metcalf/shop-exhaust-control/docs/site/dust collector.jpg

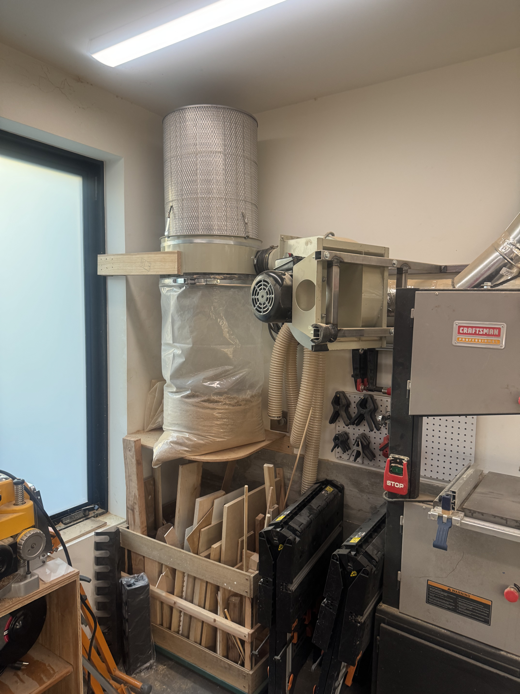
docs/site/dust collector.jpg
