metcalf/shop-exhaust-control/docs/site/mounting location option - near rear door.jpg

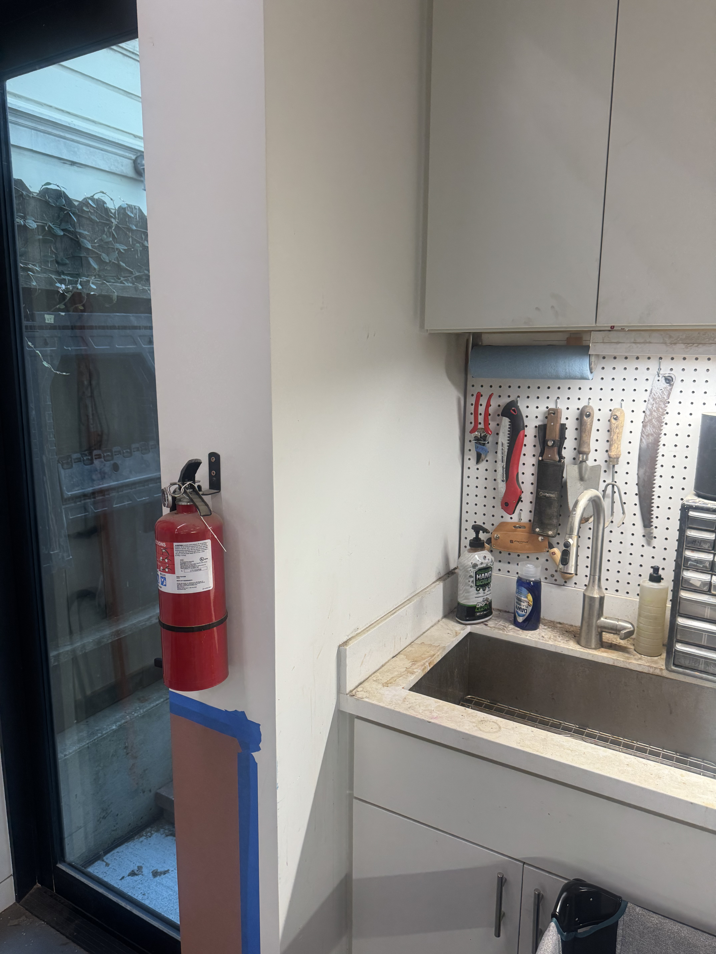
docs/site/mounting location option - near rear door.jpg
