metcalf/shop-exhaust-control/docs/decisions.md

# Decision Log

ADR-lite format. Status is one of: **Proposed**, **Accepted**, **Superseded by D-nnn**, or **Rejected**. Gate approvals are logged here too.

Keep this log to live decisions. When one is superseded, delete it if the new entry's alternatives already record why; keep a rejected entry only if the idea is likely to be re-proposed. Working assumptions live in `docs/context.md` until they're decided. IDs are never reused.

Template:
```
## D-nnn: Title
- Date:
- Status:
- Context:
- Decision:
- Alternatives considered:
- Consequences:
```

---

## D-001: Exhaust fan controller is the pilot project
- Date: 2026-10-22
- Status: Accepted (Andrew)
- Context: Two related projects, exhaust fan control and DC control, plus a new Claude-led design process to try out.
- Decision: Build the exhaust controller first.
- Alternatives considered: DC first (higher value, but more I/O, distributed wiring and a 3 HP motor contactor).
- Consequences: The exhaust project defines the `DC_RUNNING` interface. The DC project reuses this repo's structure and its process notes.

## D-002: Separate controllers, coupled by one signal
- Date: 2026-10-22
- Status: Accepted (Andrew)
- Context: The two systems share only "DC running," plus an optional shared UI.
- Decision: Independent ESP32 nodes. Shared UI and history go in Home Assistant.
- Alternatives considered: One combined controller.
- Consequences: Each node must work on its own (NFR-01). The interface lives in `docs/interfaces.md` §1; transport is BLE (D-016).

## D-003: Local physical controls; Home Assistant for history and alerts
- Date: 2026-10-22 (revised 2026-10-23)
- Status: Accepted (Andrew)
- Context: Andrew doesn't want to pull out a phone at the bench.
- Decision: Physical controls and indicators in the shop. Need not be analog: a small display is fine, resistive touch possible but physical controls preferred. Not presumed to be a fixed mode list; the interaction model is in `docs/requirements.md` §2. Home Assistant handles logging, notifications and remote viewing, and may trigger the same actions as the panel.
- Consequences: Precedence between panel and Home Assistant is decided at G2 (`docs/interfaces.md` §4). *Update 2026-10-24:* HA control dropped for v1 (FR-16); HA is read-only, so no precedence rule is needed yet.

## D-007: Bare ESP-IDF firmware, reusing the hvac_control network stack
- Date: 2026-10-23
- Status: Accepted (Andrew, 2026-10-23, including extraction)
- Context: Andrew writes ESP32 firmware in bare ESP-IDF. `~/code/hvac_control` already has a working Wi-Fi/OTA/remote-log/MQTT base (`components/wifi`) and two Home Assistant MQTT-discovery clients built on it. The DC controller will need the same stack.
- Decision: ESP-IDF in C++, not ESPHome. Control logic is a pure C++ component, host-tested. Reuse `components/wifi`, extracted with history into `metcalf/esp-iot-core` and consumed as a git submodule at `components/esp-iot-core`, matching how hvac_control already pulls in its other shared libs. HA integration follows the `MqttHomeClient`/`MqttZCHomeClient` pattern.
- Alternatives considered:
  - ESPHome: less code for HA entities, but not Andrew's workflow, and complex logic ends up in C++ external components anyway.
  - Copy `components/wifi` into this repo: fastest, but forks it three ways once the DC project starts.
- Consequences: hvac_control switches to the submodule on branch `extract-esp-iot-core`, mounted at `components/esp-iot-core` (consumers `REQUIRES esp-iot-core`); both firmware builds and host tests pass. `release.sh` takes `OTA_DIR_PREFIX` (default `hvac_control_`); each project sets its own OTA URL template, MQTT user and `remote_spec.cfg` in gitignored per-checkout files. The Python reference model is dropped (Andrew, 2026-10-23); the logic has one implementation, tested on the host in C++.

## D-008: Custom PCB with third-party assembly
- Date: 2026-10-23
- Status: Accepted (Andrew, direction; mains and DIN-rail constraints lifted 2026-10-23); details confirmed at G2/G3
- Context: Andrew wants to try a custom PCB for this project. He has designed mains PCBs before. He can hotplate-reflow SMD and is open to third-party PCBA.
- Decision: v1 uses a custom PCB: ESP32-S3 module, power, PM sensor connector, optocoupled `DC_RUNNING` input, control-panel and indicator I/O, and outputs. Mains on the board is allowed; whether the supply, relay or contactor are on or off board is decided at G2. Mains sections follow IEC 62368-1 creepage/clearance with reinforced insulation to accessible low voltage, documented in `pcb/SAFETY.md` (SR-01a). Enclosure is custom; no DIN-rail constraint. KiCad design, assembled by JLCPCB by default using parts it stocks; leftovers hand-soldered or reflowed by Andrew.
- Alternatives considered:
  - Dev board plus modules: no layout risk, but more wiring and a bigger enclosure. Kept as the fallback on the same pinout.
  - Low-voltage-only board (initial draft): simpler review, but rules out an on-board supply or relay that may make the build smaller. Remains an option at G2.
- Consequences: Phase 3 adds a KiCad project with ERC/DRC and fab/PCBA outputs; G3 review covers the board. The PCB order is a purchase, approved at G4. Claude's layout needs Andrew's review in KiCad. Mains layout is the highest-risk part of Claude's weakest area, so Andrew reviews it at G3 against `pcb/SAFETY.md`.

## D-009: Occupancy-based Auto; encoder plus configurable buttons
- Date: 2026-10-24
- Status: Accepted (Andrew, direction); floor level and thresholds set at commissioning
- Amended 2026-11-09 by D-048: the encoder and buttons are replaced by a touch panel. The Auto, hold and scene model stands.
- Context: Requirements review. Spraying is infrequent and doesn't justify a dedicated button. Andrew expects the sensors to do most of the work, with manual overrides rare.
- Decision: In Auto, an occupied shop always gets a low ventilation floor; the fan turns off only when the shop is vacant and the air is clear. Panel: encoder with push (multi-step hold entry, defaulting to the last values) plus about 4 unlit buttons whose assignments are configuration (initially Auto, Quiet, Boost, spare). Scenes stay as an extensible concept; Spray is a scene, not a button. No backlit buttons; state is shown on the display and the ambient indicator.
- Alternatives considered:
  - Sensor-only on/off (previous FR-02): no baseline ventilation while working.
  - Dedicated Spray button, or one press per action with no menus: optimizes for rare actions.
- Consequences: The occupancy input moves from S to M (FR-07); it's trusted as correct, with no failure handling (Q-17), and the display shows occupancy. PCB routes about 4 button inputs with no LED drivers. Button mapping lives in config, not in the state machine.

## D-010: PCB/electrical toolchain built around Claude's weak spots
- Date: 2026-10-24
- Status: Accepted (Andrew, 2026-11-09). KiCad 10 in place of 9 (D-035); no mains on the board (D-018), so the mains-zone items don't apply
- Context: Claude is reasonable at schematic topology but error-prone at symbol/footprint pin mapping and readable sheet placement, and weak at layout (D-008). The toolchain should turn those into scripted, checkable steps.
- Decision:
  - **Schematic:** native KiCad 9, generated with `kiutils` (Python) rather than hand-written S-expressions. Symbols, footprints and 3D models from `easyeda2kicad` by LCSC part number; LCSC fields via `kicad-jlcpcb-tools`.
  - **Verification:** render sheets and board with `kicad-cli` (`sch export svg`, `pcb export svg`, `pcb render`) and review the images; scripted netlist assertions against datasheet pin requirements (strapping pins, EN RC, decoupling, opto input); ngspice for the analog bits (`DC_RUNNING` input, snubbers, supply). Results are committed.
  - **Mains spacing:** KiCad 9 custom DRC rules, including `creepage`, encode the IEC 62368-1 spacings; `pcb/SAFETY.md` cites the rule file. Third-party layout tools never stand in for this check.
  - **Layout:** Claude scripts placement (pcbnew/IPC API): board outline, edge connectors, antenna keepout, mains zone with slots, net classes. Mains section is pre-routed and locked. From the same locked placement, generate one candidate with Freerouting and one with Quilter (free tier, KiCad in/out); both must pass our DRC; Andrew picks one and touches it up.
  - **Outputs:** KiBot/KiKit for Gerber/BOM/CPL; InteractiveHtmlBom for hand-placed parts.
  - **Off-board wiring:** WireViz (YAML) in `electrical/`.
  - **Mechanical fit:** `kicad-cli pcb export step` into the build123d enclosure assembly (D-011) for interference checks.
- Alternatives considered:
  - Hand-written `.kicad_sch`: works but unreadable placement, no structure for checks.
  - SKiDL/atopile (circuit-as-code): good netlists, but no schematic sheet for Andrew to review. Reconsider for the DC controller.
  - Flux: browser platform with its own format; conflicts with the repo/KiCad/`kicad-cli` workflow.
  - DeepPCB: overlaps Quilter; try only if Quilter disappoints. JITX: commercial, overkill.
- Consequences: Phase 3 needs KiCad 9 (`kicad-cli`, creepage DRC) on the working machine (Q-14), plus Python deps (`kiutils`, `easyeda2kicad`) and Freerouting (Java). Quilter is a cloud upload and its creepage/slot handling is unverified, hence our DRC as the gate. The Freerouting-vs-Quilter comparison is recorded in `docs/process-notes.md` for the DC project.

## D-011: Mechanical toolchain: build123d, checked by renders and geometry tests; outsourced PA12 enclosure
- Date: 2026-10-24
- Status: Proposed — needs Andrew (build123d choice accepted in principle by Andrew 2026-10-24; enclosure material tied to Q-18)
- Context: Claude's mechanical errors are mostly orientation/selector mistakes, assembly fit, and manufacturability, not the parametric geometry itself. Andrew expects to outsource SLS printing of the enclosure.
- Decision:
  - **CAD:** build123d (FOSS, OCCT kernel, STEP export) instead of CadQuery. Explicit objects, `Location`s and named faces replace chained string selectors (`>Z`), the main source of silent orientation errors. No mechanical code existed yet, so switching is free.
  - **Single source of truth:** connector, mounting-hole, display and encoder positions are read from the `.kicad_pcb` file via pcbnew Python, never retyped. The KiCad STEP export goes into the assembly.
  - **Checks:** headless renders (iso, six orthographic views, section cuts) via PyVista/trimesh for Claude to review; pytest assertions for bounding boxes, minimum wall thickness, boss/insert clearances, and zero pairwise interference volume across the assembly (PCB included); trimesh watertight/manifold checks on exported meshes.
  - **Fabrication outputs:** STEP for Fusion; dimensioned drawings via FreeCAD headless (TechDraw) for anything Andrew cuts or welds (mounts, brackets); 1:1 PDF templates for cutouts and hole patterns, checked on the real parts before cutting.
  - **Enclosure process:** outsourced PA12 powder-bed nylon. Default MJF PA12 at JLC3DP, ordered with the PCB; SLS if the vendor or finish demands it. Design rules: ≥2 mm walls, brass heat-set inserts in bosses, ~0.3 mm clearance on mating fits, powder-escape holes for closed voids, gasketed lid if needed for dust.
- Alternatives considered:
  - CadQuery: same kernel and fine, but its selector API produces wrong-face errors that build without complaint.
  - Zoo (KCL/text-to-CAD): commercial; duplicates code-CAD with more lock-in.
  - SLA resin: brittle for a shop enclosure. FDM: fine if Andrew prints, but slower to dial in remotely. Off-the-shelf listed enclosure with machined cutouts plus a printed bezel: the fallback if mains ends up inside (Q-18).
- Consequences: Phase 3 mech needs Python deps (`build123d`, `pyvista` or `trimesh`, `pytest`) and FreeCAD for drawings. Standard PA12 is not flame-rated (typically UL94 HB), so it can't be the fire enclosure around mains; Q-18 resolves this at G2. CLAUDE.md updated from CadQuery to build123d.

## D-012: One Sensirion SEN65 module for PM, VOC/NOx and RH/T
- Date: 2026-10-24, revised 2026-10-25
- Status: Accepted (Andrew, 2026-10-25, Q-24)
- Context: Sensors went through PMS5003 → SPS30 + SGP41 (Q-08, Q-09) → plus a coarse sensor and an SHT4x for VOC humidity compensation. The SHT4x needs enclosure self-heating compensation; the SEN55 combines everything but is NRND at Sensirion (`sourcing/pm-sensor.md`).
- Decision: A single SEN65 (SEN6x family, active): PM mass and number concentrations, VOC and NOx indices, RH/T. No coarse dust sensor (FR-17 dropped) and no separate RH/T sensor, so the sensor bay has one airflow path.
- Alternatives considered:
  - SEN55: cheaper and has a gas-only mode, but NRND.
  - SPS30 + SGP41 (+ SHT4x): independent failure of PM and VOC, but two airflow paths and the compensation problem.
  - Adding a coarse sensor: dropped for one airflow path; v2 candidate.
- Consequences:
  - No gas-only mode: VOC is measured only while the module measures PM. Acceptable (Andrew): when dust is high and PM sampling is sparse, the fan is already high.
  - The VOC baseline must survive module sleep (FR-14); check the SEN6x for algorithm-state backup/restore at G2, else keep a host-side baseline on the raw signal.
  - SEN6x runs on 3.3 V with peaks of ~350 mA for 2 ms; the supply and decoupling are sized at G2.
  - Fan auto-clean behavior isn't documented for SEN6x; plan a manual clean command on a schedule (NFR-02).
  - A module fault takes out PM and VOC together (SR-04).
  - Price unchecked; the SEN66 is ~$62 at DigiKey and the SEN65 should be lower. Checked at G4.

## D-013: Fan and node on always-on 120 V; lighting relay no longer switches the fan
- Date: 2026-10-25
- Status: Accepted (Andrew, 2026-10-25, Q-19: use the existing unswitched receptacle)
- Context: Survey §2: the fan's receptacle is switched by a relay driven from the 24 VAC lighting transformer, so the fan loses power when the lights go off. Auto (D-009) turns the fan off only when the shop is vacant *and* the air is clear, which needs the fan to run after the lights go off.
- Decision: Plug the fan and the node's listed supply into the existing unswitched receptacle in the cabinet. No rewiring. The 24 VAC transformer stays and becomes the occupancy input only (FR-07).
- Alternatives considered:
  - Keep the relay: the fan stops when the lights go off, so no vacant clear-down and Spray run-on dies with the lights. Contradicts FR-02/FR-08.
  - Controller switches mains itself: unnecessary, since 0 % PWM is true off (Q-15), and it would put mains in the enclosure (Q-18).
- Consequences: IR-05. No mains work, so G3 for this is a check that the receptacle's circuit is suitable. The fan's off state now depends entirely on the control port. The fan runs at full speed with the cable unplugged (Q-15), but SR-08 holds it off whenever the node is unpowered or booting, so a dead node means no exhaust until noticed (HA offline alert, FR-13).

## D-015: Controller at the north (exhaust) end
- Date: 2026-10-25
- Status: Accepted (Andrew, 2026-10-25), replaces D-014 (panel above the miter station). Spot: under the north-wall upper cabinets, < 10 ft of cable to the fan cabinet (Q-23). **Spot amended by D-033** (refrigerator side panel); the north-end choice stands
- Context: Makeup air enters at the south end and the hood exhausts at the north, so air flows the length of the shop. A sensor at the miter station (D-014) would be blind to everything downstream of it: the lathe, the north bench (soldering) and spraying north of it.
- Decision: Panel, ambient indicator and sensors go together at the north end, out of the hood's capture zone. Spot: hung under the north-wall upper cabinets (Q-23), at least 3 ft from the hood's edge, facing south down the shop. The enclosure hangs from the cabinet bottom with the display and controls angled toward the user, and the sensor inlet faces into the room. All site wiring (fan port, 24 VAC, supply) is local to the fan cabinet. Whether the DC gets its own panel or shares this one is deferred to the DC project.
- Alternatives considered:
  - Above the miter station (D-014, accepted earlier on Q-10): close to the work and the DC wiring, but blind downstream and needed a 35 ft ceiling cable. Splitting the sensors from the panel was also possible, but separating them buys nothing once the sensors are at the north end.
  - Directly beside the fan, under the cabinet (survey option 3): least wiring, but inside the hood's draw and poorly visible.
- Consequences: Sensing integrates the whole shop and clears last, so the off decision is conservative; upstream sources are detected later, which DC boost largely covers. Manual controls are at the north end, by the interior door you enter through. The DC wired link is no longer nearly free, which led to D-016. IR-04 shrinks to a short local cable.

## D-016: BLE advertising for the DC link, with no wired or MQTT path
- Date: 2026-10-25
- Status: Accepted (Andrew, 2026-10-25). **Amended by D-025** (wired backup input added)
- Context: With the controller at the north end (D-015), a wire from the DC would be a separate ~30 ft run. ESP-NOW was considered, but it shares the Wi-Fi channel, so AP outages and channel changes would need a channel-sweep scheme and an `esp-iot-core` change.
- Decision: The DC node broadcasts `DC_RUNNING` in BLE advertisements; the exhaust node scans and treats P-24 of silence as "not running". No wired input, and no MQTT fallback, for simplicity (Andrew). Message format in `docs/interfaces.md` §1, versioned and with room for DC status and a reverse direction.
- Alternatives considered:
  - Dry contact into an optocoupler: robust and simple, but a dedicated wire run.
  - ESP-NOW: better range and lower latency, but tied to the Wi-Fi channel.
  - MQTT node-to-node fallback: dropped; it adds a second path to test for a non-critical function.
  - BLE GATT connection: more state than a few bytes at a low rate needs.
- Consequences: BLE and Wi-Fi time-share the radio; the scan duty and coexistence get tested with OTA (AC-22). Adds the NimBLE stack to RAM and flash; checked at G2, with a PSRAM module as the fallback. Supersedes the transport text in D-002's consequences; D-002 itself (separate nodes, coupled by one signal) still stands. Loss of the link costs only boost. Commands to the DC, if ever added, need authentication.

## D-017: VOC index computed on the node from the SEN65 raw signal
- Date: 2026-10-25
- Status: Proposed (G2). Reversible in firmware
- Context: FR-14 needs the VOC baseline to survive module Idle. The module's index algorithm resets whenever a measurement starts. D-012 left two options: the module's algorithm-state backup/restore, or a host-side baseline on the raw signal.
- Decision: Run Sensirion's open-source gas index algorithm (BSD-3, plain C) on the node, fed one step per valid 1 s raw VOC reading. Pause it (keep its state) while the module isn't measuring and for C-07 after each start. Save the state to NVS hourly and restore it at boot. Publish the module's own index too, as a check.
- Alternatives considered: Module state backup/restore (fewer lines of code, but behaviour across long Idle is undocumented, and recorded traces can't be replayed through the module). It stays as the fallback if the raw signal proves unusable on the bench.
- Consequences: Deterministic, so host tests and HA replay run exactly the same algorithm (FR-12, AC-28). Phase 3 confirms that the SEN6x raw VOC command exists and is humidity-compensated inside the module. Restoring a stale state after a long node outage is accepted; the algorithm re-adapts over hours.

## D-018: No mains in the design; listed 12 V adapter
- Date: 2026-10-25
- Status: Proposed (G2). **Adapter and on-board supply amended by D-030** (5 V USB-C); "no mains" stands
- Context: CLAUDE.md leaves on- or off-board mains to architecture. The fan is switched off through its control port (Q-15, D-013), so there's no relay or contactor to host. Q-18 (a) prefers no mains in the printed enclosure.
- Decision: No mains on the PCB or in the enclosure. A UL-listed 12 V / ≥ 1 A Class 2 adapter plugs into the always-on cabinet receptacle and feeds a barrel jack. On board: fuse, reverse-polarity FET, TVS, 12→5 V buck, 5→3.3 V buck, plus a switched 5→3.3 V LDO for the SEN65.
- Alternatives considered: 5 V USB-C adapter (cheaper by one buck, but ~0.3 V drop over 10 ft at peak, and a second external USB-C next to the fan's USB-C port invites mis-plugging; see D-020). On-board mains supply (saves the adapter, but brings SR-01a, `pcb/SAFETY.md` and a flame-rated enclosure for no functional gain).
- Consequences: SR-01a isn't triggered. G3 covers only the receptacle circuit, the adapter listing and the 24 VAC hookup (SR-07). PA12 is fine as the enclosure material.

## D-019: One enclosure: sealed electronics above an open sensor bay
- Date: 2026-10-25
- Status: Superseded by D-057 (2026-11-10). Was accepted with G2 (Andrew, 2026-10-28). Mounting amended by D-033: wall cleat on the fridge side panel, not a cabinet bracket
- Context: NFR-03/04/09, D-015 (under the north cabinets), Sensirion's guidance to keep the module below heat sources.
- Decision: One PA12 enclosure hung from a cabinet bracket. The sealed electronics compartment is on top, with the panel on the front face and the light bar along its bottom edge. The open sensor bay is below, with a front grille and a tool-less cover; the module cable crosses through a sealed grommet. Cables enter at the back or top with strain reliefs.
- Alternatives considered: A separate sensor pod on a short cable (better thermal separation, but I²C over a longer run and two enclosures). Sensor bay beside the electronics (shorter enclosure, but at the same height as the heat).
- Consequences: Phase 3 mech models two compartments and a grommet pass-through. The SEN65 RH/T offset is tuned at commissioning.

## D-020: Flashing USB is internal; the fan port is the only external USB-C
- Date: 2026-10-25
- Status: **Superseded by D-030** (USB-C is now external, as the power input and flash/log port). Earlier amended by D-026
- Context: The S6 control cable is USB-C (stock controller J1). If the fan cable went into a node USB port, the fan's +10 V and GND would land on non-isolated node pins, bypassing SR-09.
- Decision: The ESP32-S3 native USB-C is inside the electronics compartment, reachable only with the lid off. OTA is the normal update path (NFR-11). Power comes in on a barrel jack (D-018).
- Alternatives considered: External flashing port with a label (relies on the label). A non-USB connector for the fan (needs a custom or cut fan cable).
- Consequences: First flash and recovery need the lid off. The fan-port receptacle is labelled "FAN".

## D-021: BLE DC link: payload v1.0, fast-burst advertising, 30 % scan
- Date: 2026-10-25
- Status: Proposed (G2). Shared with the DC project, so changes after G2 need a decision entry
- Context: D-016 chose BLE advertising. AC-22 needs assertion within 3 s and no false assertions, with Wi-Fi running.
- Decision: Manufacturer-specific data with company ID 0xFFFF, magic "MS", version, type, sender, sequence, flags (bit 0 `DC_RUNNING`) and reserved status and MAC fields (`docs/interfaces.md` §1.1). The DC side advertises every 100 ms for 5 s after a change, then every 500 ms. The exhaust side scans passively, 30 ms every 100 ms.
- Alternatives considered: A constant 500 ms interval with a higher scan duty (more radio time taken from Wi-Fi). Extended advertising (BLE 5; not needed for 21 bytes).
- Consequences: The DC project implements the encoder from this table. The exhaust side tests the parser and timeout on the host.

## D-022: ESP32-S3-WROOM-1-N16R8, 2.8" IPS display module, LVGL
- Date: 2026-10-25
- Status: Proposed (G2)
- Amended 2026-11-09 by D-048: the display is the capacitive-touch DLS29028B; "no touch" and the ST7789 option no longer apply.
- Context: D-008 named the ESP32-S3. D-016 flagged NimBLE RAM, with a PSRAM module as the fallback. Andrew's hvac_control already uses LVGL.
- Decision: The N16R8 module (octal PSRAM, so GPIO 35–37 are unavailable). A 2.8" 240×320 **IPS** SPI display module (ST7789 or ILI9341-IPS class) on a header, **no touch** (Andrew, 2026-10-28; was 2.0"). LVGL via `esp_lcd`.
- Alternatives considered: N8 without PSRAM (cheaper by ~$1; RAM is tight with NimBLE, TLS OTA and LVGL). A bare FPC panel (cheaper, but a fine-pitch connector and backlight circuit on our board). 2.0" IPS (smaller enclosure; same 240×320, so text is ~30 % smaller at the user's distance under the cabinet). 2.8" TN (common and cheap, but washes out viewed from below). Resistive touch (dulls the image; the encoder and buttons cover input, D-009).
- Consequences: GPIO plan in `docs/interfaces.md` §2. The display module's outline feeds the enclosure in phase 3; the bezel and board grow to about 50 × 86 mm for the module. Backlight ~2× the 2.0" draw (power budget updated, ≈ 1.5 W typical). Sourcing must confirm IPS from the panel datasheet. Cost ≈ +$3 per board.

## D-023: Fan-powered, fail-off isolated fan interface
- Date: 2026-10-25
- Status: Accepted with G2 (Andrew, 2026-10-28). Q-26 answered: the stock controller draws ≈ 9.3 mA from the port, so the ≤ 9 mA budget is within demonstrated capacity. 5 V LDO removed by D-044
- Context: SR-08 requires the fan to be off with the node unpowered, with the hold-off powered from the fan side. SR-09 requires isolation. FR-18 needs the tach.
- Decision: A fan-side N-MOSFET holds the speed line low by default (gate pulled up from a 5 V LDO on the fan's +10 V). A Schmitt-output opto driven by the node's PWM releases it, so the LED-on fraction is the fan duty. Two more optos carry the tach and a fan-present signal back. ≥ 3 mm barrier (`docs/interfaces.md` §2.1).
- Alternatives considered: An isolated DC-DC powering the fan side from the node (fails on, since the hold-off dies with node power). A relay on the speed line (slow; can't PWM at 5 kHz). A digital isolator (needs a few mA on both sides, no better than the opto here).
- Consequences: A brief full-speed burst is possible when fan mains returns before the node's hold-off rail is up; accepted (D-028, G2 review S-1). If the port can't supply the current (Q-26), the fallback is a smaller budget: drop the presence LED and raise the pull-up values. Phase 3 verifies the opto polarity and timing (architecture §9). AC-18 scopes it.

## D-024: Q-28 control-logic calls: user overrides always win; sensor faults drop only sensed demand
- Date: 2026-10-26
- Status: Accepted (Andrew, Q-28). Amends approved FR-08, FR-18, SR-04 and AC-05, AC-07, AC-20; drops P-19 and C-10
- Context: The G2 draft made five interpretations the approved requirements didn't spell out (Q-28 (a)–(e)).
- Decision:
  - (a, d) An Auto press returns to Auto from any mode, including Spray and SprayRunOn, with no run-on. Any new hold or scene replaces Spray or its run-on. The 3 s long-press and the "refused during Spray" rule are gone.
  - (b) Confirmed: the SEN65 idles from Spray start until C-07 before the P-09 minimum run-on ends. FR-08 now says so.
  - (c) A sensor fault removes only PM/VOC demand; the occupancy floor (P-01) and DC boost stay, within the FR-19 vacant limits. P-19 (fault fallback speed) is dropped, since the floor already gives the "low speed" Q-07 asked for.
  - (e) The `fan_port` fault (fan side unpowered: cable unplugged → fan full, or no mains) is accepted and written into FR-18.
- Alternatives considered: as drafted (long-press, refusal, literal SR-04). Andrew chose simpler, override-first behavior.
- Consequences: SR-03 still holds: only explicit user input ends Spray early, never a sensor or network path. Leaving Spray by Auto press means the SEN65 starts from Idle, so for ~1 min (P-06, C-07) Auto runs only floor and DC demand. That's an accepted cost of the override. If an accidental Auto press while spraying turns out to bite, the fix is a firmware change (e.g. a run-on on Spray exit by Auto).

## D-025: Keep a wired, opto-isolated `DC_RUNNING` input as a BLE backup
- Date: 2026-10-26
- Status: Accepted (Andrew, Q-28 (f)). Amends D-016 and approved IR-01, AC-06
- Context: D-016 dropped the wired input for simplicity. Andrew wants it kept on the board as a backup in case BLE disappoints, and as the simpler AC-06 bench test.
- Decision: A second AC-input opto channel (`DC_IN`, GPIO1, J-DC 2-pos 3.5 mm screw terminal, D-032), the same circuit as occupancy but accepting 12–24 V AC or DC of either polarity (`docs/interfaces.md` §2.3). `dc_running = dc_ble OR dc_wired`; an unconnected input reads false, so no configuration. The BLE payload (D-021) is unchanged.
- Alternatives considered: dry-contact input with an isolated local source (needs an isolated supply on the node); no wired input (D-016 as was).
- Consequences: About $1 per board, one more cable entry and GPIO (spare 1 used). The DC project can drive it with a relay contact switching its own 12–24 V, or straight from the 24 VAC if it has one. AC-06 runs on the wired input; AC-22 still covers BLE once a test sender or the DC node exists. A spoofed BLE frame or a wired assert both only boost.

## D-026: Fan cable hard-wired into a 4-position terminal, no USB-C on the node
- Date: 2026-10-26
- Status: Accepted (Andrew, Q-25). Fan-side TVS removed by D-042
- Context: J-FAN was a USB-C receptacle, which needed the fan cable's USB-C contact map (Q-25) and created the mis-plug hazard D-020 addressed.
- Decision: J-FAN is a 4-pos 3.5 mm terminal (fixed screw, D-032) on the fan side of the barrier, labelled GND (BLK) / +10V (RED) / SPD (YEL) / TACH (WHT). Andrew hard-wires the four conductors (from the S6's Q-15 color map).
- Alternatives considered: USB-C receptacle wired to the measured contact map (needs Q-25 and a symmetry check).
- Consequences: Q-25 is closed with no measurement needed. No USB-C fan cable reaches the node. Mis-termination is the new risk: color labels, fan-side TVS, and the AC-18 bench check.

## D-027: Holds and scenes survive non-power resets (RTC memory)
- Date: 2026-10-28
- Status: Accepted (Andrew, Q-29). Amends approved NFR-07 and AC-18. Resolves G2 review B-1
- Context: Any reset ended Spray, so an OTA reboot, a stack panic or a watchdog trip could turn the fan off while vapor was present (SR-03).
- Decision: The current mode and its remaining time (any hold or scene, including Spray and SprayRunOn) live in RTC no-init memory with a CRC and are restored after every reset except power-on and brown-out. OTA isn't deferred, and a stuck task still just reboots (Andrew: no extra recovery machinery).
- Alternatives considered: Defer OTA during Spray and recover a stuck sensor task in place (proposed; more code paths for the same result).
- Consequences: A crash or OTA reboot costs a few seconds of fan-off (hardware hold-off during boot). A crash loop during a scene keeps resuming that scene, which is the safe direction for Spray. Power loss still returns to Auto. The Controller stays pure: snapshot/restore is host-tested; the RTC storage is platform code.

## D-028: Fan port treated as SELV on measured evidence; basic barrier kept; power-up burst accepted
- Date: 2026-10-28
- Status: Accepted (Andrew, Q-22/Q-30 measurements, S-1), confirmed by Q-31 (≈ 60 µA into 10 kΩ, under the 0.5 mA ES1 limit). Resolves G2 review B-2; closes S-1
- Context: B-2: the barrier is basic insulation while the port's SELV status was unknown, and lid-off flashing and AC-18's scope touch the fan side. S-1: when fan mains returns with the node off, the speed line can read high before the LDO-fed hold-off is up.
- Decision: Unplugged, port GND is open to L, N and earth (resistance and diode). Plugged in, ~65 VAC open-circuit to N/earth, which is consistent with Y-capacitor coupling from an isolated supply into a 10 MΩ meter. On that evidence the port is treated as SELV. The ≥ 3 mm basic barrier is kept for the ground loop and the capacitive float, with no fan-side cover or "unplug before service" rule. S-1's fan power-up burst is accepted (Andrew), so the LDO-fed hold-off stays.
- Alternatives considered: Reinforced barrier and fan-side cover regardless (unnecessary if Q-31 confirms). Feed Q1/U1 from +10 V to close S-1 (stays an option if Q-26 shows the port current is tight, since it also cuts the draw).
- Consequences: If Q-31 reads above the ES1 touch-current limit (0.5 mA), B-2's reinforced fix applies before layout. AC-18 records fan power-up behavior instead of requiring it to be off.

## D-029: Phase 3 starts with the schematic and a priced parts list
- Date: 2026-10-28
- Status: Accepted (Andrew). Checkpoint passed 2026-11-09: Andrew approved the schematic and priced list (Q-33); layout may start
- Context: The part choices (ESP32 module, H11L1-class opto, regulators, display) drive cost, JLC extended-part fees, board size and enclosure dimensions. Pricing was planned for phase 4, after the mech and firmware work that depends on those parts.
- Decision: After G2, phase 3 runs in this order: (1) PCBA vendor check (JLC Economic rules, Q-14); (2) KiCad schematic, ERC clean; (3) priced parts list from the schematic: LCSC basic/preferred/extended status, stock, price, fees, plus off-board parts; Andrew reviews it as a checkpoint; (4) only then PCB layout, mech and firmware. G4 still approves the final BOM.
- Alternatives considered: phase order as in CLAUDE.md (design everything, then source).
- Consequences: Part swaps to cut extended-part fees (e.g. LTV-814 → PC817 + diode, 5→3.3 V buck → AMS1117, enabled LDO → AMS1117 + AO3401) are made in the schematic, not after layout. The firmware host-test work also waits; it doesn't depend on hardware, but Andrew wants the cost picture first.

## D-030: Single external USB-C for power and flash/log; 3.3 V only
- Date: 2026-10-28
- Status: Accepted (Andrew). Amends D-018 (adapter, on-board supply) and NFR-04; supersedes D-020. Polyfuse removed by D-040
- Context: Nothing on the node needs 5 V except the indicator LEDs, which can run from a 5 V input directly. D-018's two reasons for 12 V were the mis-plug risk next to a USB-C fan cable (gone with D-026) and cable drop into a 5 V rail (moot once everything regulates to 3.3 V).
- Decision: Power comes from a listed 5 V USB-C adapter (≥ 2 A) through the node's only external USB-C, which is also the native-USB flash/log port. On board: polyfuse, TVS, one 5→3.3 V regulator (buck or low-dropout LDO, picked in the schematic), and a P-FET load-switched 3.3 V sensor rail. The receptacle sits behind a compressed foam gasket in the wall, facing the cabinet; its mouth is an accepted NFR-04 exception (Andrew: reduced IP5X intent is OK if sealing adds complexity).
- Alternatives considered: 12 V barrel with an internal USB (D-018/D-020 as was: two regulators, lid-off flashing). A gasketed panel-mount USB-C pigtail (better seal, more parts and a cable inside).
- Consequences: Fewer parts (no 12→5 V buck, no reverse-polarity FET, no barrel jack, no VBUS OR-ing), and flashing/logs without opening the lid. The input cable needs 24 AWG or heavier power conductors and ≤ 3 m. Running from a PC port during flashing means a lower indicator cap. No 12 V headroom for future loads.

## D-031: Indicator: plain RGB, short strip by the display; sensor load switch kept for recovery
- Date: 2026-10-28
- Status: Accepted (Andrew)
- Context: FR-15 needs one band color (or a red fault flash) readable down the shop; nothing needs per-LED effects. The 12-LED bar along the enclosure's bottom edge had no derivation behind its count. Separately: does the SEN65 need a power switch when sleep uses the module's Idle command?
- Decision: Plain RGB LEDs driven by three LEDC PWM channels through low-side N-FETs from the 5 V input; no WS2812B or level shifter. A short diffused strip aligned with one edge of the display; length, diffuser depth and LED count are set in mech (~4–8 LEDs). No illuminated encoder (Andrew: only worth it as a simpler or cheaper replacement for the strip, and a lit shaft isn't readable down the shop, FR-15). The SEN65 load switch stays, for unattended recovery of a hung module only (a node reboot doesn't reset it); S-13's back-powering fixes are applied.
- Alternatives considered: WS2812B bar (extended part plus shifter; effects not wanted). Illuminated RGB encoder as the indicator (too small and dim for FR-15 at ~30 ft; costs more than a plain EC11 plus a few LEDs). No sensor switch (two fewer parts; a hung sensor then needs a USB replug).
- Consequences: GPIO 48/41/42 for R/G/B; one spare (GPIO 2) left. The LEDs and FETs are probably JLC basic parts, but each LED needs a resistor per color. `SEN_PWR_EN` is active low with a gate pull-up (the earlier "pull-down" was wrong for a P-FET).

## D-032: Fixed screw terminals for all field wiring
- Date: 2026-10-28
- Status: Accepted (Andrew)
- Context: J-FAN, J-OCC and J-DC were pluggable. Andrew plans to wire it once, and a plug can't pass back out through a gland sized for its cable, so pluggable saved nothing on removal.
- Decision: Fixed 3.5 mm screw terminals (one part, 2- and 4-position) for J-FAN, J-OCC and J-DC, inside the sealed compartment behind the cable glands.
- Alternatives considered: Pluggable terminals (a bench swap without re-terminating; ~$1–2 more and a mis-plug question). Pluggable headers through the rear wall (lid-closed removal, but another sealing gap).
- Consequences: Taking the unit down means lid off and unscrewing the conductors. The J-OCC/J-DC mis-plug question and the pitch-keying go away. One terminal part family for the BOM.

## D-033: Controller on the refrigerator side panel next to the hood
- Date: 2026-10-28
- Status: Accepted (Andrew, Q-27/Q-32, 2026-10-28). Amends D-015's spot and approved NFR-09, IR-04
- Context: Andrew proposes the side of the refrigerator panel beside the hood (`docs/site/mounting location option - next to intake.jpg`): within reach, near the airflow, still visible from most of the shop. NFR-09 wants the sensor inlet ≥ 3 ft from the hood's edge; the panel looks closer.
- Decision: Wall-mount a few inches back from the panel's front edge, center ~60" up (hood intake ~66"); the panel face is ~18" laterally from the hood's edge, so the inlet is ≈ 2 ft from the hood. Display, controls and light strip on the front, which faces across the kids' workbench; the strip sits on the front's room-side edge and wraps the corner so it also reads down the shop. Sensor inlet on the bay's corner-side end (north, toward the back wall ~1 ft away), which shelters it from knocks and debris; not downward (Sensirion guidance). Open air in front, outlet separated (Andrew). NFR-09 now states what placement must achieve (open inlet, not facing down, no strong draft, outlet separated, AC-17 shows no fan-induced shift) instead of a fixed distance and direction.
- Alternatives considered: Under the north cabinets ≥ 3 ft from the hood (D-015 as written; harder to reach).
- Consequences: The enclosure becomes a flat wall mount, not a cabinet-hung unit (D-019's compartments stay; the slide-off bracket becomes a wall cleat). The kids' workbench below (glue, markers, hot glue) will show as local VOC/PM and can raise the fan; accepted unless AC-17 or commissioning shows it misleads clear-down. The panel is within the kids' reach at the bench; no lock (Andrew: they're old enough). Cable route from the fan cabinet down the panel edge, < 10 ft.

## D-034: PCBA on JLCPCB Standard, single-sided
- Date: 2026-10-28
- Status: Accepted (Claude; reversible until the order). Andrew to confirm at the priced-parts review (Q-33)
- Context: Q-21 aimed for JLC Economic PCBA. The vendor check (`sourcing/pcba-vendor.md`) found the ESP32-S3-WROOM-1-N16R8 (C2913202) listed as "Standard Only", so Economic can't place it.
- Decision: JLCPCB Standard PCBA, all parts on the top side; JLC also places or wave-solders the THT parts. Estimated ≈ $150–180 for 5 boards, components included.
- Alternatives considered: Economic without the module, which Andrew hotplate-reflows himself: saves ≈ $20 but adds a manual step on the most expensive part. Switching to an Economic-eligible module (C3-WROOM-02): loses PSRAM and GPIOs, so it would reopen D-022. PCBWay: quote-based, with setup ≈ $90–150 (unverified), so likely dearer.
- Consequences: setup ≈ $26 plus $8 stencil. The vendor note says $1.53 per unique part on Standard, Basic included; that's unverified, and JLC has historically waived Basic. Either way, fewer unique parts is the lever (`sourcing/priced-parts.md`).

## D-035: Schematic as code (kiutils generator, label per pin)
- Date: 2026-10-28
- Status: Accepted (Claude; tooling, reversible). Implements D-010 under KiCad 10
- Context: KiCad 10.0.7 is installed. kiutils 1.4.8 reads the KiCad 10 symbol libraries and writes schematics that kicad-cli 10 loads, ERC-checks and netlists (tested). kicad-cli hangs inside the Claude sandbox unless it has its own config dir.
- Decision: `pcb/gen/build.py` generates `pcb/exhaust.kicad_sch` from stock KiCad symbols. Every pin gets a net label at its endpoint (no drawn wires). `pcb/gen/check.py` asserts the design properties on the exported netlist: isolation domains and crossings, fail-off pulls, GPIO plan, switched-rail pull-ups. `pcb/tools/kicad-cli` wraps the CLI with a repo-local, gitignored config dir seeded with the stock library tables. The generator stays the source until layout starts. After that, the `.kicad_sch` becomes the source (Andrew may edit it in the GUI), and check.py keeps running on it.
- Alternatives considered: writing S-expressions from templates (more code, no gain); KiCad's IPC API (needs a running GUI).
- Consequences: the sheet is label-heavy, unlike a hand-drawn schematic; text placement on rotated parts needs GUI touch-up. The netlist assertions catch injected faults (mutation-tested). Footprints are stock KiCad placeholders until checked against the LCSC drawings (pcb/design.md O-3).

## D-036: 24 VAC and wired DC inputs: bridge + PC817C, one circuit for both
- Date: 2026-10-28
- Status: Accepted (Claude; schematic-level, reversible before layout). Resolves G2 review S-5; replaces the LTV-814 in interfaces §2.2–2.3 and D-031's "PC817 + antiparallel diode" swap
- Context: the antiparallel-diode swap conducts on only one half-cycle, leaving gaps of ≥ 8 ms. S-5 showed that the old 10 k pull-up chatters at 12 VAC with minimum CTR.
- Decision: J-OCC and J-DC share one circuit: SMBJ48CA → 2 × 2.7 k 1206 → MB10S bridge → PC817C-S (CTR 200–400 %), 47 k pull-up and 1 µF. Worst cases in `pcb/design.md` §3: ≥ 20× margin at 12 VDC − 10 %, 0.12 V ripple at 12 VAC − 10 %, 65 mW per resistor at 26.4 VAC.
- Alternatives considered: LTV-814 AC-input opto (Extended, not stocked as cheaply); two PC817s with antiparallel LEDs (an extra opto per input).
- Consequences: one fewer unique part type. J-OCC and J-DC stay interchangeable. 12–24 V AC/DC of either polarity works (IR-01).

## D-037: 3.3 V from an SY8089 buck; VBUS sense on the spare GPIO
- Date: 2026-10-28
- Status: Accepted (Claude; reversible before layout). Fills D-030's "buck or LDO" choice. The VBUS sense part is superseded by D-039; the buck by D-040
- Context: a 5 → 3.3 V LDO dissipates ≈ 0.6 W at the 0.35 A typical load, which is too much for SOT-23-5 in a sealed box. D-030 left an optional CC read for the indicator cap.
- Decision: SY8089AAAC (2 A) with a 2.2 µH inductor and 2 × 22 µF output. GPIO2 reads `+5V` through a 100 k / 100 k divider, and firmware lowers the indicator cap when the supply sags.
- Alternatives considered: TLV757 LDO (thermal); reading CC1/CC2 (two ADC pins, and it doesn't see cable drop).
- Consequences: no spare GPIO remains. Open item O-4: hot-plug overshoot against SY8089's 6 V abs max (maybe input bulk).

---

## Gate approvals
| Gate | Date | Approved by | Notes |
|---|---|---|---|
| Phase 0 survey | 2026-10-25 | Andrew (with G1) | Survey and photos committed d9833fd |
| G1 Requirements | 2026-10-25 | Andrew | `docs/requirements.md` as of this commit, including the SEN65 consequences (FR-14 baseline survival, FR-08 sensor sleep during Spray minimum run-on) |
| G2 Architecture | 2026-10-28 | Andrew | `docs/architecture.md`, `docs/interfaces.md`, `docs/control-logic.md` and D-017…D-033 as of this commit; review `reviews/G2-review.md` (B-1…B-3 resolved, should-fix items triaged in STATE.md). D-019 and D-023 accepted with G2. Phase 3 order per D-029 |
| G3 Mains/safety | | | |
| G4 BOM | | | |
| G5 First power-up | | | |

## D-038: Generated schematic draws wires within blocks
- Date: 2026-11-09
- Status: Accepted (Claude, at Andrew's request; tooling, reversible). Amends D-035's "label per pin"
- Context: Andrew found the label-per-pin sheet hard to follow in review.
- Decision: `pcb/gen/build.py` marks blocks with `sh.begin()`. At write time, GND/+3V3/+5V pins get power symbols. Pins sharing a net within a block are joined by orthogonal wires (`pcb/gen/route.py`: no touching other nets' pins or wires, no T-joins to them, no running through symbol bodies, hops ≤ ~40 mm). Each wired group keeps one net label, so net names and cross-block links are unchanged, and anything unroutable falls back to a label.
- Alternatives considered: hand-placing wires per block (brittle when parts move); leaving it for GUI cleanup after hand-off (review happens before then).
- Consequences: the netlist is identical before and after (94 nets, same names and members; ERC 0, check.py passes). Labels drop from 359 to 165. Wire quality depends on placement, which wasn't laid out for wiring, so some blocks (indicator, MCU) are still mostly labels, and rotated-part text overlaps remain.

## D-039: No VBUS sense; GPIO2 left spare
- Date: 2026-11-09
- Status: Accepted (Andrew). Supersedes D-037's VBUS sense and D-030's lower indicator cap on a PC port
- Context: D-037 sensed `+5V` so firmware could lower the indicator cap on a weak PC port. The installed node runs from a listed ≥ 2 A adapter, normal logging is over Wi-Fi, and Andrew's PC port supplies 3 A against a 1.1 A worst-case peak. The installed cable makes the threshold unworkable: about 0.55 Ω (3 m of 24 AWG plus the polyfuse) puts `+5V` near 4.7 V with the indicator at its cap (≈ 0.56 A, estimated) and near 4.4 V at peak, from an exactly 5.0 V source. That is within roughly 100 mV (estimated divider and ADC error) of the 4.6 V threshold, so it could dim the indicator on the correct adapter.
- Decision: remove the divider and filter cap (2 × 100 k, 100 nF) and leave GPIO2 unconnected. The indicator keeps its fixed 300 mA firmware cap.
- Alternatives considered: keep it for cable-drop diagnostics (a multimeter at commissioning covers that); reading CC1/CC2 (already rejected in D-037). If a lower cap on a PC is ever wanted, firmware may be able to detect a USB host through USB-Serial-JTAG with no hardware (API not yet checked).
- Consequences: three fewer parts and one spare GPIO before layout. Cost change is negligible, so `sourcing/priced-parts.md` was not regenerated. Sag only dims the LEDs slightly; the buck still regulates 3.3 V.

## D-040: No VBUS fuse or bulk cap; AP63203 wide-input buck
- Date: 2026-11-09
- Status: Accepted (Andrew). Supersedes D-037's buck and D-030's polyfuse. Closes O-4
- Context: Andrew questioned F1, since overcurrent protection normally sits in the source. No safety argument relied on it (`pcb/SAFETY.md` relies on the LPS adapter), `+5V` reaches no field terminal, its hold current derates to the 1.1 A peak near 85 °C, and it drops ≈ 0.11 V. O-4's proposed 47–100 µF bulk cap was also wrong: a non-PD USB sink is limited to 1–10 µF (figures from TI datasheets quoting the spec; the spec itself wasn't read), and the schematic already had 20 µF nominal. Estimated hot-plug peaks (6.6–8 V, not measured) still exceed the SY8089's 6 V abs max.
- Decision: remove F1, tie VBUS to `+5V`, keep one 10 µF on the rail, and replace the SY8089 with the AP63203WU-7 (35 V abs max, fixed 3.3 V). Keep the 2.2 µH inductor (`pcb/design.md` §1). `check.py` asserts the capacitance limit and the buck wiring.
- Alternatives considered: bulk cap (violates the limit); RC snubber (needs several times the input capacitance, same limit); leaving the SY8089 (a shorted high side could put 5 V on `+3V3`); 17 V-class bucks (many have a 4.5 V minimum, against the ≥ 4.4 V budget).
- Consequences: AP63203 is $1.21 @10 against $0.15, but F1 and the 22 pF go away, so there are two fewer unique parts. Standard PCBA for 2 boards goes from ≈ $156 to ≈ $154 (that also includes D-039's removals). Stock is 1,337 on 2026-11-09. A board fault below the adapter's limit is no longer interrupted on the board. That makes Q-36's G3 check that the supply is LPS the protection the design depends on.

## D-041: EN and BOOT on screwdriver pads, no switches
- Date: 2026-11-09
- Status: Accepted (Andrew). Fills the "switches or pads" option in G2 review S-14
- Context: SW1 (EN) and SW2 (BOOT) are only for setup and recovery. Normal flashing uses `esptool`'s reset over USB-Serial-JTAG and updates are OTA, so BOOT only matters if firmware stops USB from responding.
- Decision: remove both switches. EN and BOOT each get their own adjacent GND pad (TP6 + TP2, TP7 + TP8), with the board's minimum copper clearance within a pair (Andrew: easier to bridge) and ≥ 10 mm between pairs, so two screwdrivers can hold both at once: short BOOT, tap EN, release BOOT.
- Alternatives considered: one shared GND pad between EN and BOOT (no room for two tips; would mean holding BOOT while plugging in USB); keeping the switches (parts and space for a rare operation).
- Consequences: one fewer unique part. Recovery needs the lid off and two tools, which is rare. The other tact switches and the encoder renumber to SW1–SW5. The pad spacing is a layout rule in `pcb/design.md` §5, since the schematic can't enforce it.

## D-042: No TVS diodes on the fan lines
- Date: 2026-11-09
- Status: Accepted (Andrew). Amends D-026
- Context: D-026 added an SMF15A on red, yellow and white as mis-termination protection. Andrew noted the stock AC Infinity controller has none on the same port. The only source on this cable is the fan's own 10 V, below the TVS's 18.5 V breakdown, so a wrong-terminal wiring error never reaches it. On reversed polarity it conducts forward and shorts the fan's low-current +10 V. Line-to-`GND_F` clamps don't address common-mode noise, which the barrier handles. The exposed parts (HT7550 and Q1 drain, 30 V) have margin on a 10 V port.
- Decision: remove all three. Keep the 1 µF on `+10V_F`, the color-coded terminal labels and the AC-18 bench check. The SMBJ48CA diodes on the 24 VAC and `DC_RUNNING` inputs stay, because those lines connect to a transformer secondary and external wiring.
- Alternatives considered: keep only red (no named fault it handles either); keep all three as cheap insurance (no fault to insure against, and it costs a unique part).
- Consequences: three fewer parts and one fewer unique part. ESD while wiring the terminals is unclamped, which is a brief exposure. An unforeseen transient could kill the fan side of a board, which fails off.

## D-043: No series diode on tach; separate presence opto stays
- Date: 2026-11-09
- Status: Accepted (Andrew)
- Context: D5 (1N4148W) in series with U6's LED only blocked reverse bias if the fan drove white above `+5F`. Q-15's stock 10 k pull-up to 5 V points to an open-drain output, so white doesn't go above our pull-up. Even a 10 V push-pull output would put ≈ 5.1 V across the LED, inside the PC817's 6 V limit. Andrew also asked about carrying presence and tach on one opto, with the open-collector output shunting the LED. That reads a steady LED-off as "cable out", which fails if a stopped tach can rest low. Hall-derived tach outputs plausibly can, and no source confirmed otherwise.
- Decision: remove D5. Keep U6 and U7 as separate optos, which also keeps the board flexible across different fans.
- Alternatives considered: one opto with a shunt or FET inverter (needs the stopped-level behaviour of each fan; saves ≈ 4 parts and GPIO6).
- Consequences: one fewer part and unique part. Tach LED current goes from 1.1 mA to 1.2 mA at datasheet max, for a fan-side total of ≈ 4.4 mA against the ≤ 9 mA budget.

## D-044: No fan-side regulator; run the fan interface from +10V_F
- Date: 2026-11-09
- Status: Accepted (Andrew). Amends D-023
- Context: The H11L1 operates at 3–15 V (16 V abs max), so it doesn't need `+5F`. Andrew: the datasheet curve shows ICC doesn't rise significantly from 5 V to 10 V, and red measured about 10 V. He also judged that an open-collector tach output tolerates the 10 V the fan generates itself.
- Decision: remove the HT7550 and `+5F`. The H11L1 VCC, the Q1 gate pull-up, and 10 k feeds to the tach and presence LEDs all run from `+10V_F`. White has no separate pull-up: the tach LED's 10 k feed pulls it up. Q1's gate sits at 10 V (AO3400A ±12 V max).
- Alternatives considered: 10 k / 10 k dividers to hold Q1's gate and white near 5 V as the stock controller does (one more resistor for an unproven need).
- Consequences: three fewer unique parts and a fan-side total of ≈ 4.1 mA. White rests near 9 V instead of the stock 5 V, an assumption AC-18 should confirm on the first bench power-up. The part directly on red goes from 30 V tolerance to 16 V. Q1 Vgs margin to its limit is about 2 V. References renumbered: H11L1 is now U4, tach U5, presence U6, OCC U7, DC U8.

## D-045: LTV-817S-TA1-C replaces PC817C-S
- Date: 2026-11-09
- Status: Accepted (Andrew). Amends D-036's part number
- Context: Andrew spotted the LTV-817 on JLC's line. C109227 (Lite-On LTV-817S-TA1-C) is the same 4-pin phototransistor opto, labelled Basic on its JLC page, with 282,150 at LCSC on 2026-11-09. The Lite-On datasheet (DS70-2012-0050 Rev. B) gives pins 1 anode, 2 cathode, 3 emitter, 4 collector, C rank 200–400 % at IF = 5 mA, 5 kVrms, UL 1577 file E113898 and VDE 60747-5-5.
- Decision: use C109227 for all four optos (U5–U8), same symbol. Unranked variants (LTV-817S-TA1 and LTV-817S) are ruled out because the margins depend on C rank.
- Alternatives considered: keeping UMW PC817C-S (cheaper unit price, Extended).
- Consequences: $0.045 more per opto, one fewer Extended part, and a recognised maker's UL file. Andrew read typical CTR at 1 mA as 80 % from the full sheet, which replaces `pcb/design.md`'s assumption: tach and presence margin ≈ 4.7×. Lead span differs slightly from the footprint (O-3).

## D-046: No TVS on J-OCC and J-DC
- Date: 2026-11-09
- Status: Accepted (Andrew). Amends D-036 and D-042's note that these stay
- Context: Each input already has 5.4 k in series, a 1 kV bridge and a 5 kV opto. J-OCC's real transient source is the transformer switching with the lights, but with the relay coil still across the secondary it's unlikely to approach the roughly 800 V where the two 1206s reach their pulse limit (limit from memory, not read). J-DC is a BLE backup with nothing on it yet; any contactor kick belongs to the DC project.
- Decision: remove both SMBJ48CA. Keep the series resistors, bridge and opto.
- Alternatives considered: keep them as cheap insurance against a mains surge coupled through the transformer; scope the 24 VAC terminals at switch-off first (not done).
- Consequences: two fewer parts, one fewer unique Extended part. A large surge could open a resistor and kill the occupancy input, on a board with a spare. A 120 VAC mis-wire burns the 1206s open instead of clamping across mains.

## D-047: No power switch on the SEN65
- Date: 2026-11-09
- Status: Accepted (Andrew). Supersedes D-031's load switch and D-030's load-switched sensor rail; G2 review S-13's pull-up placement no longer applies
- Context: D-031 kept the switch for unattended recovery of a hung module, with no reported failure behind it. Six threads and two searches (2026-11-09) found no SEN5x/SEN6x that needed a module power cycle; startup failures were wiring, ground, I/O voltage or a software retry. One SEN66 garbage-data report is unresolved with no power cycle tried, and the only power-cycle reports are on SCD4x and SDP8xx. A hang costs little under SR-04: floor and DC boost keep working and the fault shows on the panel.
- Decision: remove Q2, its gate parts and the bleed resistor. SEN65 VDD and the I²C pull-ups go to `+3V3`; keep 10 µF + 100 nF at J5. GPIO10 is spare. C-12 stays as the retry interval for I²C bus recovery and the module reset command.
- Alternatives considered: keep it (five cheap parts, but a firmware sequence and a bench check for a failure with no evidence).
- Consequences: a truly locked-up module needs a USB replug, since a node reboot doesn't reset it. Firmware should reset and retry the module at startup (the Tasmota SEN55 report needed this).

## D-048: Touch-only panel on the Elecrow DLS29028B
- Date: 2026-11-09
- Status: Accepted (Andrew, 2026-11-09). Amends D-009 and D-022, and §3, FR-01, NFR-04, NFR-10 and AC-08 of the approved requirements. Answers Q-35
- Context: The physical panel had reached a workable design (sleeves, floating rods, vinyl overlay) but needed real mechanical work. Andrew chose to avoid that complexity. Removing the controls saves only about $13, so cost wasn't the driver. The module with touch was already the default for Q-35 at the same price.
- Decision: The 2.8" capacitive touch module (Elecrow DLS29028B, equivalent to LCDwiki MSP2834; ILI9341V, FT6336G) is the only local input. Encoder, four buttons and the backlight FET are removed. J6 is a 1×14 socket with VCC on `+5V` and GPIO47 driving the backlight pin. Touch uses its own I²C bus on GPIO15/16 with RST and INT on 17/18. Two 2N7002 shifters are required, because the module pulls CTP_SCL and CTP_SDA to VCC on the header side. Bus at 100 kHz.
- Alternatives considered: Physical controls (recorded in `docs/physical-controls-record.md`). A larger 3.5" display (more enclosure, cost and sourcing for no need at arm's length). Display boards with the ESP32 on them, with an I²C expander and WS2812B on a carrier: the CYD and Elecrow DIS04028H-1 have too few pins and no PSRAM, and the Waveshare ESP32-S3-Touch-LCD-2.8 saves only ≈ $15–25 net while keeping a custom carrier. Other touch-line options: removing R4/R6 on each module (rework that a replacement silently undoes), VCC at 3.3 V (dims the backlight). AO3400A shifters (630 pF Ciss, ≈ 5 µs rise).
- Consequences: No gloved or by-feel operation, and no local control if the panel or touch controller fails; control logic keeps running and Home Assistant can still trigger actions. The bezel exposes the glass, with a gasket around it for NFR-04. `+5V` carries the module, within the 10 µF limit because J6 has no local bulk cap. Five GPIOs remain spare (2, 10, 38–40). 2-board PCBA ≈ $135 on Standard, 29 unique parts.

## D-049: J-FAN as two 2-pos terminals; one 10 k series resistor on the AC inputs
- Date: 2026-11-09
- Status: Accepted (Andrew). Amends D-026/D-032 (J-FAN terminal), D-036 and D-046 (series resistance)
- Context: The 4-pos XY350V (C557656) was a unique Extended part used once. The 2-pos KF128L is already on the board for J-OCC and J-DC. The 2 × 2.7 k 1206 (C17950) on each AC input was also Extended; a 10 k 1206 (C17902) is Basic.
- Decision: J-FAN becomes J2 (GND, +10V) + J7 (SPD, TACH), two KF128L-3.5-2P end to end. Each AC input uses one 10 k 1206 in place of 2 × 2.7 k.
- Alternatives considered: keep the 4-pos block (one-piece wiring); 2 × 4.7 k Basic (two parts per input for transient withstand).
- Consequences: two fewer unique Extended parts (28 unique). Standard PCBA for 2 boards ≈ $133, project ≈ $240–265. Input margin at 12 VDC − 10 % drops from ≈ 16× to ≈ 8×; 24 VAC + 10 % dissipation ≈ 70 mW in one 1206 (`pcb/design.md` §3). One 1206 instead of two roughly halves the series pulse withstand that D-046 relied on in place of the TVS. Layout keeps J2 and J7 adjacent on the fan island, with the silkscreen labels in the order of the fan cable colors. ERC 0, netlist assertions pass.

## D-050: Keep the fan-side opto barrier
- Date: 2026-11-09
- Status: Accepted (Andrew). Reaffirms D-023 and D-028; SR-09 and AC-26 unchanged
- Context: The stock S6 controller connects to the port with no isolation, and D-028 treats the port as SELV, which raised the question of dropping U4–U6. Without the barrier, fail-off (SR-08) still works: GPIO4 drives a 2N7002 onto Q1's gate, which keeps its pull-up to +10V_F. But the stock controller's only reference is the port. The node also references the USB adapter's Y-cap and an earthed laptop while flashing, so tying grounds would put the fan's ≈ 65 VAC capacitive float and its motor-drive noise on node ground. The likely victim is the FT6336G touch controller, the only local input (D-048). Its sensitive band (≈ 1–500 kHz) is where the motor-drive noise sits.
- Decision: Keep U4 (H11L1), U5 and U6 and the ≥ 3 mm barrier as designed.
- Alternatives considered: (a) Non-isolated: three 2N7002 (PWM drive, tach inverter, presence) replace the three optos. Saves ≈ $4 on 2 boards (2 unique parts: H11L1 and the 390 Ω), removes the thinnest-stock part and simplifies layout. Rejected because the touch-noise risk couldn't be measured before the build or reliably fixed after it. (c) (a) plus a ferrite bead in fan GND. A bead is ≈ 0 Ω at 60 Hz and a few Ω at 100 kHz, and in one conductor it just diverts common-mode current to the others. A snap-on core around the whole cable is the better field fix, and it needs no footprint. Capacitive coupling across the barrier: it passes the AC noise we want blocked, needs a Y-rated cap and a return per signal, and can't carry DC (presence) or 0/100 % PWM. The version that can (a gated ≈ 1 MHz carrier with a fan-side detector, fail-off on a lost carrier) is a home-made digital isolator, which costs more than the $0.41 H11L1.
- Consequences: Layout keeps the fan copper island and creepage rules (`pcb/SAFETY.md`). The H11L1's stock (1,541) and VDE marking still need a re-check at G4. Revisit (a) only if a scope trace of fan GND against earth, with the fan at level 10, shows nothing above 60 Hz.

## D-051: Project footprint library; schematic is the source from layout on
- Date: 2026-11-09
- Status: Accepted (Claude; reversible). Implements D-035's handover and closes design.md O-3/O-5
- Context: The schematic used stock KiCad placeholders. Checked against the LCSC (easyeda2kicad) footprints and datasheets, the stock 3528 RGB numbering would have put +5 V on a cathode (TOGIALED: pin 4 anode), the MB10S needed the MDD pin map (1 +, 2 −), the optos' lead spans and the inductor family (Murata LQH44P, not Bourns SRN4018) differed, and the stock ESP32-S3 footprint carries 12 EPAD vias (Q-33 says none) and a 48 × 21 mm antenna keepout.
- Decision: `pcb/lib/exhaust.pretty`, built by `pcb/layout/footprints.py`, holds LCSC footprints for the optos, bridge, LED, KF128L and inductor (the LED and bridge renumbered to their symbols) and the stock module minus EPAD vias and its keepout. The USB-C, GH, TSOT-23-6 and socket stay stock (pad-for-pad match). The `.kicad_sch` footprint fields point at the project library. From this commit `pcb/exhaust.kicad_sch` is the source; `pcb/gen/build.py` is frozen and `pcb/gen/run.sh` only regenerates with `REGENERATE=1`.
- Alternatives considered: fixing the symbols' pin maps instead (touches a reviewed schematic); keeping stock footprints with custom pin maps per part (same work, less obvious).
- Consequences: ERC 0 and the netlist assertions still pass. Silk polarity dots on the LED and bridge mark datasheet pin 1, so check D2–D9 rotations in JLC's preview at order time.

## D-052: Board outline and placement for routing
- Date: 2026-11-09
- Status: Proposed — needs Andrew (sets the enclosure; review with `pcb/LAYOUT.md` §3, Q-39)
- Context: D-010 needs a locked placement before Quilter and Freerouting. STATE left the outline and mounting to Claude.
- Decision: 72 × 123 mm 2-layer board, display side up. Display on J6 with its header at the bottom; its four holes double as the board's mounting holes. Field terminals and USB-C along the top edge; optos in a band under them with keepout barriers. Module antenna out the left edge; LED column on the right; SEN65 connector at bottom right; all test pads, including the D-041 recovery pairs, on B.Cu. Placement is the `POS` table in `pcb/layout/place.py`, written locked to `pcb/exhaust-placed.kicad_pcb`.
- Alternatives considered: a board the size of the display, with the field circuits on a daughter board (more connectors, a second barrier); terminals on the back face (screws not reachable with the display on); module under the display (antenna shadowed).
- Consequences: Over JLC's 100 × 100 price tier (a few dollars for 5 boards). Mech reads every position from the board. Unverified assumptions A3 (terminal wire-entry side), A4/A5 (which side is the room side) and A6 (rear lid) are listed for review.

## D-053: Off-the-shelf Waveshare ESP32-S3-Touch-LCD-2.8B instead of the custom PCB
- Date: 2026-11-10
- Status: Superseded by D-054 (Andrew, 2026-11-10)
- Context: Andrew asked to re-evaluate a stock board with an addressable LED module and off-the-shelf PC817 (or non-isolated) interfaces, dropping `FAN_PRESENT` and `DC_IN` if pins run short. Full analysis: `docs/eval-offtheshelf-board.md`.
- Decision: Use the Waveshare board. GPIO44 `FAN_PWM` (inverted, through a PC817 module), GPIO43 `FAN_TACH` (PC817 module), GPIO4 `OCC_IN` (lift R24; AC-input opto module), GPIO0 addressable LED data, SEN65 on the shared external I²C. Fail-off comes from a coil-powered 5 V relay module whose NC contact sits across speed–GND_F, plus a pull-up that keeps the PWM opto lit through boot. Drop `FAN_PRESENT` (FR-18 fan-port fault) and the wired `DC_IN` (D-025).
- Alternatives considered: keep the custom PCB (layout already placed; about $151 for 2 boards plus the display, more lead time); non-isolated BSS138 shifters (still fail-full when unpowered, and reintroduces the ground loop D-050 avoided); a PCF8574A expander for the dropped inputs (kept as an add-on, Q-43).
- Consequences: Amends D-008, D-022, D-025, D-030, D-031, D-048, D-050, SR-08 wording, FR-18, IR-01. Two board reworks (R24 lift, plus QMI8658 removal or an I²C mux, Q-42). Bench checks before G4: PC817 duty at 5 kHz, 3.3 V LED data, RGB panel stability with Wi-Fi.

## D-054: Waveshare board + minimal carrier PCB (route B)
- Date: 2026-11-10
- Status: Accepted (Andrew, 2026-11-10) with amendments: LTV-817 for PWM (Q-44), U6 desoldered instead of the TCA9543A (Q-42), R24 lifted for OCC on GPIO4 with no PCA9536, so FAN_PRESENT and DC_IN are dropped (Q-43). Final pin plan in `docs/eval-offtheshelf-board.md` "Chosen". Q-45 answered: on-board side-view LEDs (D-055)
- Context: Andrew wants a custom board without a mess of modules, but much smaller, using the Waveshare ESP32-S3-Touch-LCD-2.8B for the MCU, display and USB. Analysis and costing: `docs/eval-offtheshelf-board.md` (Option B).
- Decision: A carrier on the Waveshare 2×12 header holds the D-023 fan interface unchanged (H11L1 + Q1 from +10V_F, so fail-off as written), LTV-817 tach, a PCA9536 (0x41) for FAN_PRESENT/OCC/DC, a TCA9543A (0x70) to put the SEN65 on its own channel, and a 2N7002 shifter for an off-board LED strip on GPIO0. GPIO44 PWM, GPIO43 tach. No Waveshare rework. JLC Economic PCBA with Basic parts wherever possible; Andrew hand-solders the connectors.
- Alternatives considered: route A (modules plus relay, D-053); lean all-custom (≈ same cost; keeps the module, USB and power design risk); R24 lift plus QMI8658 removal (cheaper by ≈ $6–9, but rework on the display board).
- Consequences: Supersedes pcb/ placement (kept as reference). Amends D-008, D-022, D-030, D-031, D-048. Keeps D-023, D-025, D-050, FR-18, SR-08. Electronics ≈ $65–100 per unit, against ≈ $144.
- Amendment (2026-11-10): with the cuts above, D-025 is reverted (BLE-only DC link), FR-18 loses the fan-port fault, IR-01 and AC-06 lose the wired backup, and D-023/D-050 stand with LTV-817 in place of the H11L1. The carrier has no Extended parts, so JLC Economic applies.
- Confirmed (Andrew, 2026-11-10): `FAN_PRESENT` and `DC_IN` stay dropped. Alternatives rejected: bodge wires to GPIO42 (SD_MISO, R63) or to the TCA9554 P4/P5 freed by removing U6 (no bodge wiring wanted); a PCA9536 expander on the carrier; GPIO33–37 (in-package octal PSRAM, which the 600 KB RGB frame buffer needs); an ADC resistor ladder on GPIO4 (the 120 Hz AC-input optos would misdecode).

## D-055: Indicator: on-board side-view SK6812SIDE-A on the carrier edge
- Date: 2026-11-10
- Status: Accepted (Andrew, Q-45)
- Context: Route B leaves one output-only pin (GPIO0, strapping) for the indicator. Plain RGB (D-031) needs three PWM pins; two discrete colours need two outputs, and no single-pin scheme keeps GPIO0 high at reset. The carrier sits behind the display, so top-emitting LEDs wouldn't show.
- Decision: A row of SK6812SIDE-A (OPSCO, LCSC C5378721, 4.0 × 2.0 × 1.6 mm side-light, 3.7–5.5 V, "Economic and Standard", checked 2026-11-10) along the carrier's room-side edge, emitting outward into a diffuser in the enclosure wall; 100 nF per LED. Driven from GPIO0 through the 2N7002 inverter (1 kΩ to 5V, 10 kΩ gate pull-up to 3V3), RMT with `invert_out`; 5V from the header; 300 mA firmware cap kept. Count (≈ 4–8) and the diffuser are set in mech; the carrier edge must reach the enclosure wall.
- Alternatives considered: off-board WS2812B strip on a 3-pin terminal (no JLC cost, but a loose cable and strip to mount); XL-0807RGBC-2812B (C3646929; listing doesn't document side emission); single-colour Basic LED on a 2N7002 (no fee, but no red/yellow/green state colours, FR-15); SK6812SIDE-A-RVS (Standard Only); SK6812D-EC3210R (C2890041, side-view per LCSC, datasheet not read).
- Consequences: amends D-031 (indicator) and D-054 (no off-board strip). Adds the carrier's only Extended part: one fee ($1.50–3.07) plus ≈ $0.11 per LED, ≈ $3–4.50 per order. Constrains carrier outline and enclosure (LED edge at the wall; the D-033 corner wrap depends on placing LEDs on one or two edges).

- Amendment (Andrew, 2026-11-10, with D-057): LEDs on the carrier's display-facing (SMT) side at its right edge, emitting out the right wall into the room. The bottom GND plane spreads their heat. The firmware cap drops to 150 mA (a band indicator never needs full white). The SEN6x temperature-offset slots (DS §4.8.14) are selected by LED state, with values set at commissioning from an LEDs-on/off log.
## D-056: Waveshare ESP32-S3-Touch-LCD-3.5 instead of the 2.8B
- Date: 2026-11-10
- Status: Accepted (Andrew, 2026-11-10: lower pixel density is OK; USB-C exposed by stepping the enclosure wall as the stock case does)
- Context: the 2.8B's 16-bit RGB panel leaves four usable GPIOs, forcing D-054's cuts (FAN_PRESENT, DC_IN) and two reworks (R24, U6). The 3.5 (SKU 30733) drives its ST7796 320×480 panel over SPI on IO1–6, so the camera pins are free and on its 2×16 2.54 mm header J8. Schematics: `docs/vendor/waveshare-3.5/` (V1 and Rev 2.0).
- Decision: use the 3.5. Free header GPIOs (no camera): 17, 18, 21, 38–42, 47, 48, plus 43/44. Avoid 0 and 45/46 (strapping). I²C on IO7/8 is shared with FT6336 0x38, ES8311 0x18, PCF85063 0x51, AXP2101 0x34, TCA9554 0x20/0x21 and QMI8658 at **0x6A** (SA0 tied to GND), so the SEN65's 0x6B is free: **no rework**. USB-C stays on the Waveshare board, exposed through a stepped enclosure wall with a gasket around the shell (NFR-04 exception as written). The carrier adds a VBUS-triggered one-shot that pulls PWRON low ≈ 3–4 s (see Consequences).
- Alternatives considered: stay on the 2.8B (sharper panel, but the cuts and rework stand); USB-C receptacle on the carrier via header VBUS/U_N/U_P (Extended part, CC resistors, TVS); right-angle extension cable to a panel mount (loose cable, clearance behind the display).
- Consequences: reverts D-054's cuts: `FAN_PRESENT` (FR-18 fan-port fault) and the wired `DC_IN` (D-025) return; D-055 indicator moves off GPIO0 to a normal pin. Rework steps (R24, U6) dropped. Display drift risk gone (SPI). **3.3 V comes from the AXP2101 DCDC1 and ESP_EN from its PWROK**, and power-on at VBUS insertion is an eFuse option (AXP2101 datasheet V1.4 §6.5.4.2, REG20), not confirmed for Waveshare's parts; ONLEVEL is eFuse (128 ms–2 s), OFFLEVEL resets to 6 s. Hence the carrier one-shot on PWRON (J8: Rev 2.0 pin 23, V1 pin 24), timed between 2 s and 6 s, **DNP by default** (Andrew, 2026-11-10), fitted only if the bench shows no auto power-on; firmware disables PWRON power-off (REG22[1]) at boot. J8: V1 and Rev 2.0 put the same signals in the same physical positions and only number the rows oppositely (Rev 2.0 numbers from the socket side), so one carrier fits both; docs use Rev 2.0 numbers. Pin plan (Andrew's go-ahead 2026-11-10): GPIO38 `FAN_PWM`, 39 `FAN_TACH`, 40 `FAN_PRESENT`, 41 `OCC_IN`, 42 `DC_IN`, 21 indicator; spares 17, 18, 47, 48, 43, 44 (`docs/interfaces.md` §2). Enclosure grows (dimensions from Waveshare's 2D/3D zip, to fetch). Supersedes D-054's choice of board, not its carrier approach.

## D-057: Landscape panel, wiring out the left side, SEN65 inside the enclosure behind the panel
- Date: 2026-11-10
- Status: Accepted (Andrew, 2026-11-10, Q-46): NFR-04 amended as below; NFR-03 relaxed with no hatch (open the main enclosure for the module, like everything else). Supersedes D-019's two-compartment form
- Context: Andrew's mech direction for the 3.5 (D-056): screen horizontal, all wires out the left side, SEN65 behind the screen on the right, facing into the room. The SEN65 has its own fan and a defined inlet/outlet, so a separate open bay (D-019) may be unnecessary.
- Decision:
  - Landscape panel. Fan, OCC, DC and USB-C cables all exit the left side. The Waveshare drawing's rear view puts the USB-C on the board's left edge seen from the back, which is the right edge seen from the front. If the STEP confirms that, mount the board rotated 180° (USB-C on the left) and rotate the ST7796 and FT6336 in firmware. The carrier's terminals go on its left edge.
  - The SEN65 sits inside the one enclosure, behind the panel on the right, its inlet facing into the room through the wall. Its inlet and outlet are each sealed to their own wall opening (gasket or printed shroud, per Sensirion's SEN6x mechanical design-in guidance), so shop air reaches only the module's flow path and never the electronics volume. Outlet separated from the inlet (NFR-09). J5 sits on the carrier's right side; the cable stays < 10 cm.
- Alternatives considered: keep D-019's open bay below the electronics (better thermal separation, a tool-less cover; but a taller enclosure, a grommet and a second compartment). A remote sensor pod (longer I²C run, two enclosures).
- Consequences:
  - Supersedes D-019's two-compartment form if accepted.
  - **NFR-04:** "sensor bay open to the room, thermally separated" becomes "the module's own flow path sealed to the wall; no shop air reaches the electronics volume".
  - **NFR-03:** relaxed: the module is reached by opening the enclosure (Andrew: a hatch is unnecessary complexity). AC-14 and AC-15 amended to match.
  - **FR-20 / NFR-09:** the ≈ 2 W of electronics heat in the same box raises the module's T/RH readings. PM is unaffected; the VOC index is only mildly affected. The commissioning offset (FR-20) covers T/RH; keep the module at the far right, away from the Waveshare PMIC and LEDs, and check AC-17.
- Amendment (Andrew, 2026-11-10): minimize enclosure size. The SEN65 lies flat behind the carrier with ≤ 1/4" (6.35 mm) between the carrier's back face and the module, with a 1/8" closed-cell foam strip (PE or EPDM, acrylic adhesive; no open-cell PU or solvent adhesives near the VOC sensor) on the module face toward the PCB, clear of the inlet and outlet. The carrier's back face stays flat: all SMT is on the display side (JLC Economic is one-sided anyway); THT stubs are trimmed flush, and the screw terminals are at the left edge, away from the module. Rough depth: ≈ 45–50 mm, to confirm from the STEP and the SEN6x drawing.

## D-058: Concept enclosure and carrier placement defaults
- Date: 2026-11-10
- Status: Accepted as defaults (Andrew, 2026-11-10: "run it tonight with those defaults"); bezel, spacer, size and SEN65-connector items superseded by D-059
- Context: first concept enclosure (`mech/concept.py`, `docs/mech-concept.md`) and first carrier placement (`pcb/carrier/LAYOUT.md`) for D-056/D-057.
- Decision:
  - Bezel and rear shell split behind the LCD (z −8). Service by lifting the unit off the cleat and removing the rear shell.
  - Clamp-and-foam strain reliefs on the left wall, centred on the placed terminals. Straight USB-C plug into a stepped pocket.
  - 6 LEDs at 9 mm pitch on the right edge only.
  - Carrier on nylon M2 × 6 spacers and nylon M2 screws into the Waveshare SMT standoffs, giving 3.6 mm of J8 pin engagement. Carrier 91.4 × 57.0 mm.
  - SEN65 stands on end, ports through the right wall, inlets at the bottom. 4.0 mm gap to the carrier. Connector on the rear face, cable looped to J5.
- Alternatives considered: SEN65 beside the Waveshare board (≈ 121 × 66 × 33 mm, 25 % less volume, but wider and next to the LEDs); a 6.35 mm gap (deeper for no gain); terminals on the front side (they'd hit the Waveshare parts).
- Consequences: enclosure ≈ 97.4 × 66.0 × 53.7 mm. The SEN65 depth is 25.6 mm rather than 21.3, because its inlets and outlet share one face. Nylon hardware is required at the field-zone holes (`pcb/SAFETY.md`).

## D-059: No bezel, 1.6 mm walls with ribs, carrier as close as the Waveshare allows
- Date: 2026-11-10
- Status: Accepted (Andrew, 2026-11-10: no bezel, glass is the face; 1.6 mm SLS nylon walls with ribs; thinner stack; carrier close behind the Waveshare, header fitted normally). Supersedes the bezel, spacer and connector items of D-058.
- Context: Andrew's review of the D-058 concept. He has used 1.6 mm SLS nylon without problems; it flexes, so ribs come before thickness.
- Decision:
  - **Outline:** the cover glass is the front face. The enclosure outline is the glass outline, 92.44 × 61.0 mm. A four-wall shell carries the glass's black border on a 0.8 mm foam rim gasket. Back panel is 1.6 mm and screwed on.
  - **Walls and ribs:** walls 1.6 mm. Back panel has 1.2 × 4 mm ribs inside, left of the SEN65 bay.
  - **Retention:** four tabs behind the carrier at the Waveshare holes. One nylon M2 screw per hole, driven from the back, passes through the tab, the carrier and the spacer into the SMT standoff. That pulls the glass onto the rim gasket.
  - **Service:** take off the back panel, then the SEN65, then the four screws; the display and carrier go out the front.
  - **J8 joint (Andrew, 2026-11-10, final):** J1 is left unpopulated at PCBA. Andrew pushes loose 2.54 mm pins into the Waveshare J8 socket, seats the carrier flush on the socket face, and solders from the back.
    - Carrier top is at z −11.5, the socket face.
    - Pins are about 8.2 mm long (taken from a standard header and trimmed).
    - The gap to the SMT standoffs is 1.1 mm, filled with a nylon shim.
    - Earlier options (body-on-back, short posts, trimmed posts, 6 mm spacers) are dropped. Q-47 is closed.
  - **Camera:** the camera module in Waveshare's STEP isn't shipped (Andrew). It's excluded (`params.NOT_FITTED`). Its FPC connector stays, and it's shallower than J8.
  - **Board-to-board space:** only 5.1 mm between the boards. The mech test checks every display-side carrier part, at its datasheet height, against the Waveshare's actual solids.
    - Two of the five LTV-817S (4.0 mm tall) hit Waveshare parts at their first positions. Resolved by re-placing them (D-060).
  - **USB-C pocket:** there's no room for a floor between the plug and the carrier. The pocket walls land on the carrier's left edge, which is kept free of display-side parts (mech test), with a foam strip to close it.
  - **SEN65 connector:** it's on the face opposite the ports (mech guide Fig. 1), so it faces into the bay left of the module. A short cable runs to J5. The 0.4 mm clearance to the back panel works.
- Alternatives:
  - Header variants, all superseded by the loose-pin flush seat: body on the carrier back (solder fillets), short or trimmed posts, 6 mm spacers.
  - 2.0 mm walls.
  - A smaller carrier: no fab-cost gain under JLC's 100 × 100 mm tier, and the LEDs and terminals would move off the walls.
- Consequences:
  - **Size:** 92.44 × 61.0 × 45.8 mm, about 258 cm³ (was 97.4 × 66.0 × 53.7, about 345). Carrier 88.24 × 56.8 mm.
  - **Glass edge:** the glass edge is exposed at the sides.

## D-060: Optos packed into the Waveshare's clear column; terminals inboard
- Date: 2026-11-11
- Status: Accepted (Andrew, 2026-11-11: Q-48 option (b), shuffle the LTV-817S into gaps; terminals inboard facing left with room on the left to dress the wires). Placement superseded by D-061 the same day.
- Context: with the carrier flush on J8 (D-059), 5.1 mm separates the boards. A 4.0 mm opto needs every Waveshare part above it to be no more than 0.9 mm tall, keeping a 0.2 mm margin. A map of the Waveshare back from the STEP's per-solid boxes shows one clear column for a 13 mm wide opto footprint: frame E x −29.6 to −16.6 (the existing barrier band), y −8.4 to +19.69.
  - **Right of it:** the 2.2 mm LCD FPC connector and the touch FPC tail block a move.
  - **Below it:** three 1.0 mm parts and the switches block a move.
- Decision:
  - **Optos:** all five at OPTO_X 21 (board coordinates), packed at a 5.6 mm pitch from y 11.55. That fits the 28.1 mm window with 0.18 mm to spare at each end.
    - Courtyards stay apart.
    - Field pads of adjacent groups are 1.56 mm apart, at least the 1.5 mm functional gap.
    - Margin to the part above each opto at its 4.0 mm maximum height: U1 0.76, U2 0.20, U3 0.20 (courtyard edge only), U4 0.40, U5 0.26 mm.
  - **Terminals:** all four KF128L move inboard. Pins are at board x 11 (was 4.5) and the wire entries face the left wall, 7.6 mm in from the inner wall (was about 1 mm). Nothing sits on the back between the wall and the terminals except the two left screw heads.
    - The pin column can't go further right: J3's pads, the 1.5 mm OCC|DC gap and U5's field pads have to fit side by side.
  - **Field parts:** on the front, left of the terminal pins and clear of the USB pocket edge.
  - **Field-field gaps:** fan|OCC is straight. OCC|DC is Z-shaped: from the opto gap it drops between J3 and U5, then runs out to the left edge between the OCC and DC parts.
  - **Clearance test:** now uses per-solid bounding boxes (exact for small parts, and it catches flat faces that a mesh-vertex check misses). The glass and LCD solids are cut to the slab behind the PCB, so only their FPC tails count. A new test asserts the wire room and the empty back-left strip.
- Alternatives:
  - (a) A low-profile SOP-4 opto: margin of more than 2 mm, but needs a new part sourced and its CTR checked.
  - (c) A 0.5 mm gap under the carrier: loses the flush seat.
  - Moving the column right or down: blocked by the Waveshare parts above.
- Consequences:
  - **Tight margins:** 0.2 mm at U2/U3 against a 0.9 mm Waveshare part. That's at the LTV-817S maximum height and the vendor STEP's modelled heights, so a Waveshare revision could eat it. The mech test is the guard. If the rev changes or a fit check is tight, fall back to (a).
  - **Slots:** cable slots stay centred on the terminals: fan 14.5, OCC 29.6, DC 46.0 (board y).

## D-061: Optos in the board-centre column, field side lower-left, terminals mid-board; old board removed
- Date: 2026-11-11
- Status: Accepted (Andrew, 2026-11-11). He asked for the terminals further toward the middle, facing x = 0. He suggested turning the optos 180° and shifting them in +y. He also asked for the test points on the bottom, and for the old design to be removed from `pcb/` because it's in git history.
- Context:
  - **Rotation:** turning the optos in their D-060 column puts the top opto's field pads about 1 mm from J8's node pads, short of the 3.0 mm barrier. That column also has no slack in y.
  - **Better column:** a scan of the Waveshare back (per-solid boxes) finds a longer clear column at the board centre: frame E x −2…11, y −19.25…+19.69 (38.9 mm, against 28.1 mm for the D-060 column).
- Decision:
  - **Optos:** in the centre column (board x 48.6), in their normal orientation: field left, node right.
  - **Barrier band:** runs down the column and turns left under J8. The whole lower-left of the board is the field side.
  - **Terminals:** pins at board x 33.0, entries facing the left wall, with 29.6 mm of wire room to the inner wall (was 7.6). Field groups are horizontal bands (fan | OCC | DC) with straight 1.5 mm gaps.
  - **Node side:** the opto partners, the PWRON one-shot (now anchored to the keep-flat edge) and the test pads move to the right of the column.
  - **Test pads:** they were already on the back (B.Cu). They now sit at the bottom edge, node side, left of the SEN65, clear of the field wiring.
  - **MB10S height:** taken as 2.7 mm (MBS/TO-269AA, ASSUME until checked against the C2488 datasheet). It was previously caught by the 1.35 mm "D" prefix meant for D1. D3 moved left of J4 to clear the Waveshare part above.
  - **Old board:** removed from the tree (schematic, placement, reports, design notes, old layout scripts; history up to `b0cada4`). Shared code moves to `pcb/common/`: schematic-as-code (`sch.py`, `route.py`, `parts.py`), `netlist.py`, the footprint builder and `dsn.py`. The Freerouting script is retargeted to the carrier (`pcb/carrier/layout/route_freerouting.sh`). `pcb/SAFETY.md` is rewritten for the carrier.
  - **Waveshare STEP:** committed (`mech/vendor/`, 23 MB; GitHub's limits are 50 MB warn and 100 MB hard), so the model doesn't depend on Waveshare's download staying up. `mech/fetch_vendor.sh` now compares upstream with the committed copy by SHA-256.
- Alternatives:
  - Turning the optos 180° in the D-060 column: fails the J8 spacing.
  - Keeping D-060: only 7.6 mm of wire room.
- Consequences:
  - **Margins:** the smallest opto margin to the Waveshare is 0.26 mm (U4). The bridges have 1.1 mm.
  - **Repo:** it's public, so the STEP is redistributed from there. Waveshare publishes it as a free download with no stated licence (Andrew's call before pushing).
  - **Open:** the 3D node↔field air clearance to the Waveshare's back-side parts (Q-49).
