metcalf/shop-exhaust-control/docs/site/floor plan.pdf

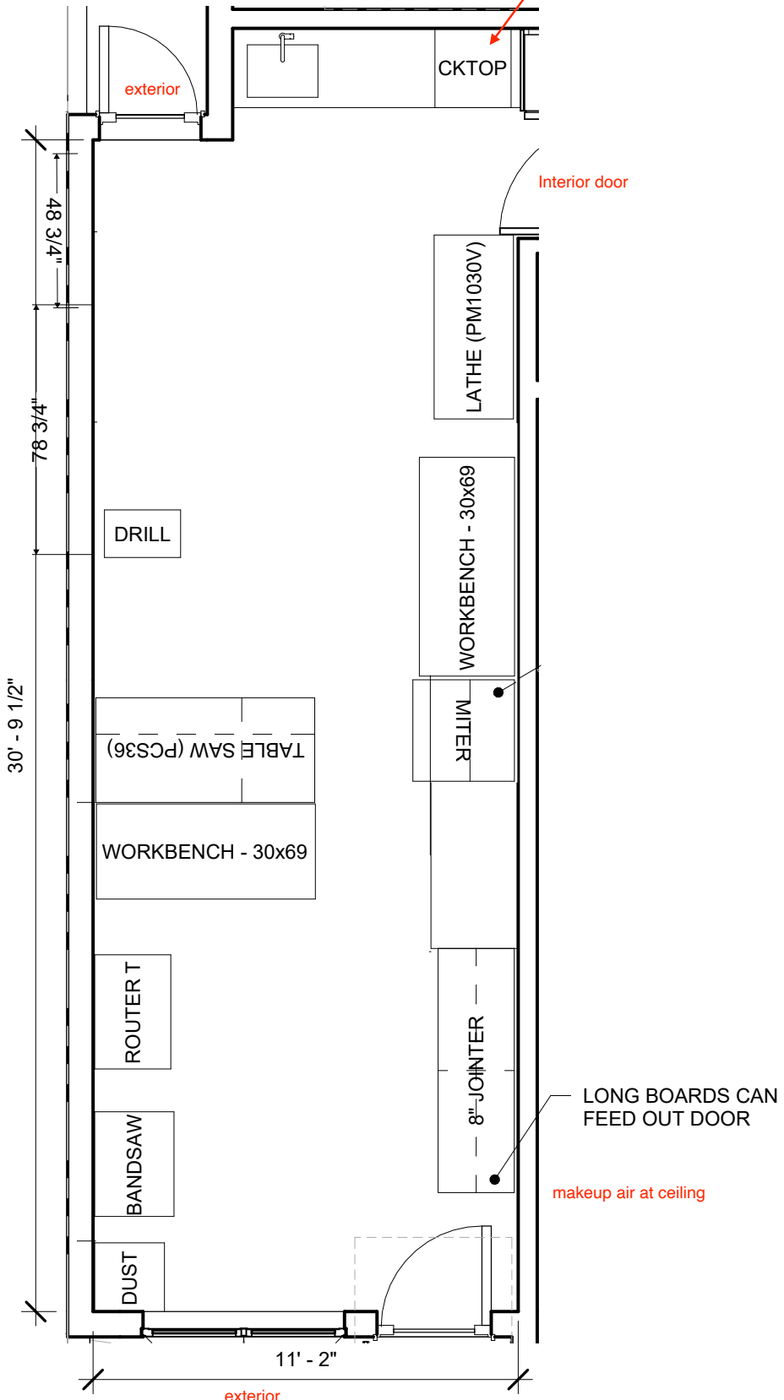
[picture p3: figure]
CKTOP; DRILL; 8" JOINTER; BANDSAW; MITER; MILL (PM-728VT); LATHE (PM1030V); ROUTER T DUST; MTL BAND; WORKBENCH - 30x69WORKBENCH ⁻ ²⁸x66; LONG BOARDS CAN FEED OUT DOOR; PLANER CAN SWAP WITH MITER SAW
