metcalf/shop-exhaust-control/docs/site/ac infinity controller pcb.jpg

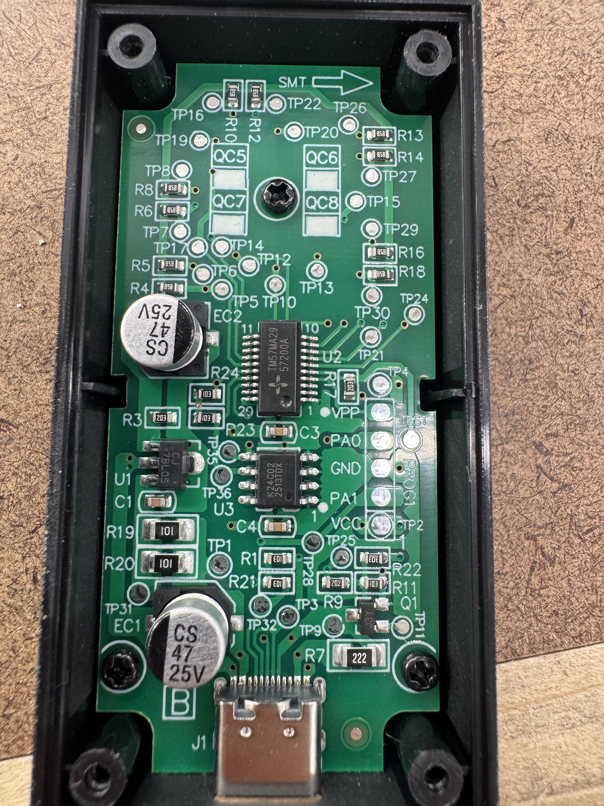
docs/site/ac infinity controller pcb.jpg
