metcalf/shop-exhaust-control/docs/site/dust collector nameplate.jpg

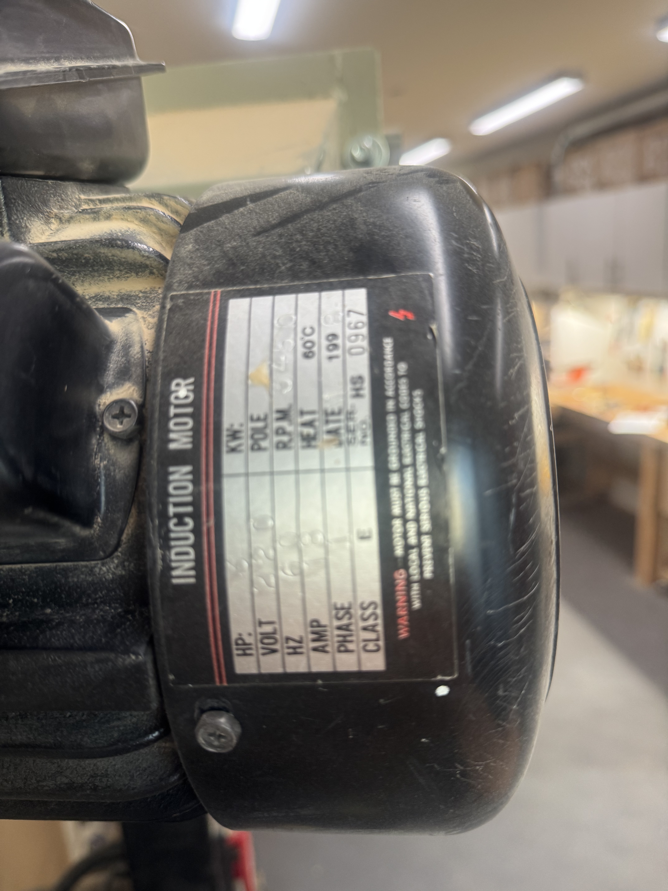
docs/site/dust collector nameplate.jpg
