metcalf/shop-exhaust-control/docs/site/exhaust fan.jpg

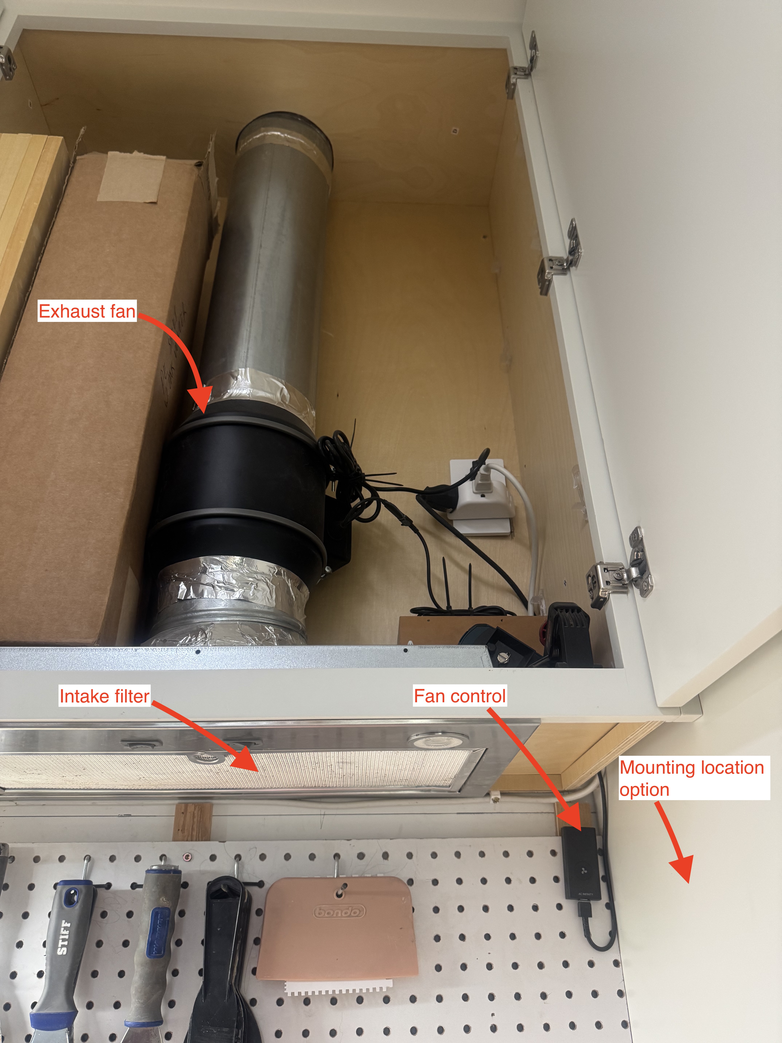
docs/site/exhaust fan.jpg
