metcalf/shop-exhaust-control/docs/site/Exterior duct termination.jpg

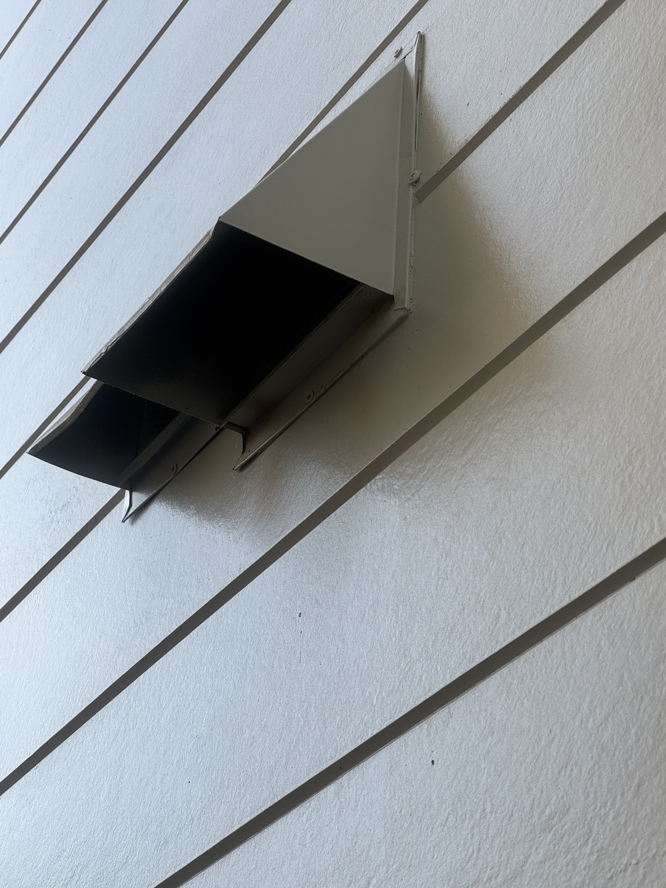
docs/site/Exterior duct termination.jpg
