metcalf/shop-exhaust-control/docs/site/mounting location option - above miter saw.jpg

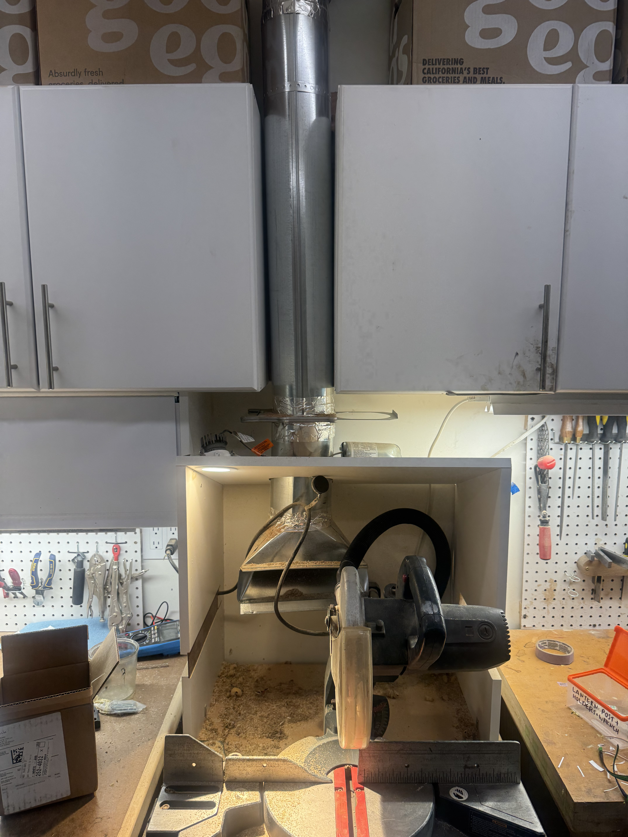
docs/site/mounting location option - above miter saw.jpg
