metcalf/shop-exhaust-control/docs/site/mounting location option - next to intake.jpg

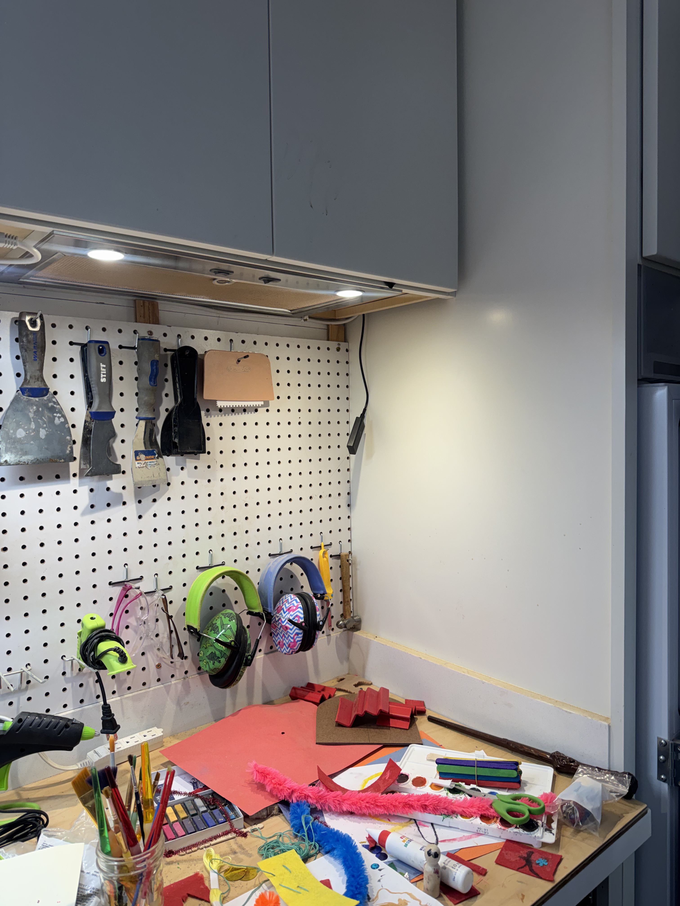
docs/site/mounting location option - next to intake.jpg
