metcalf/shop-exhaust-control/mech/out/concept-front.png

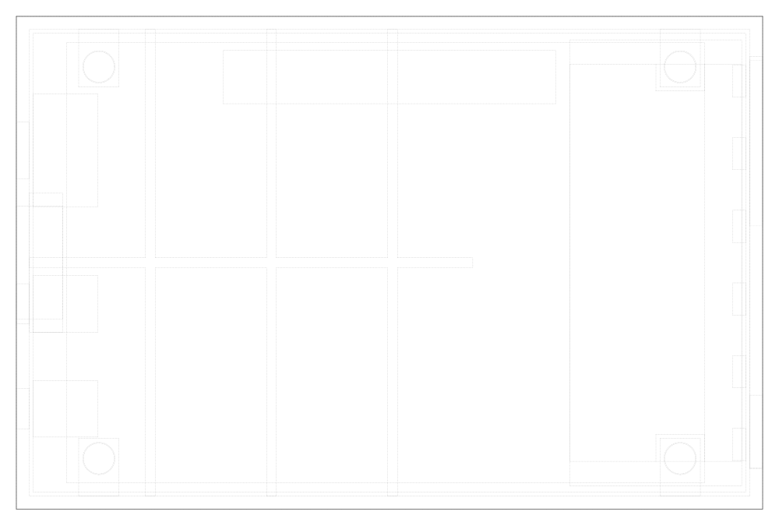
mech/out/concept-front.png
