metcalf/shop-exhaust-control/mech/out/concept-iso.png

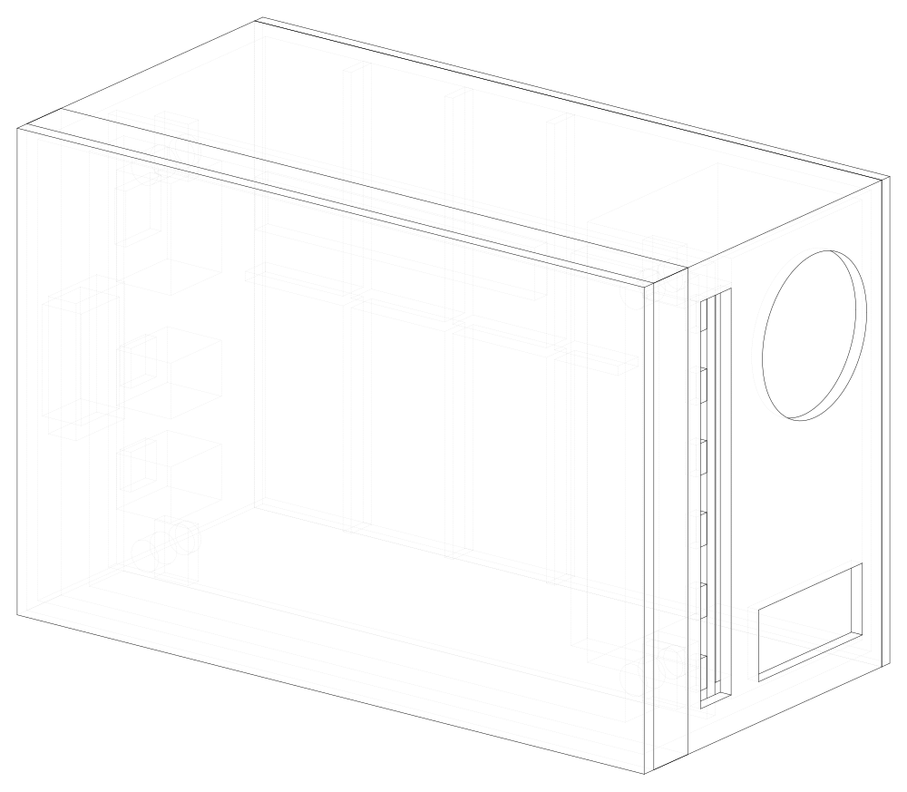
mech/out/concept-iso.png
