metcalf/shop-exhaust-control/mech/out/concept-right.png

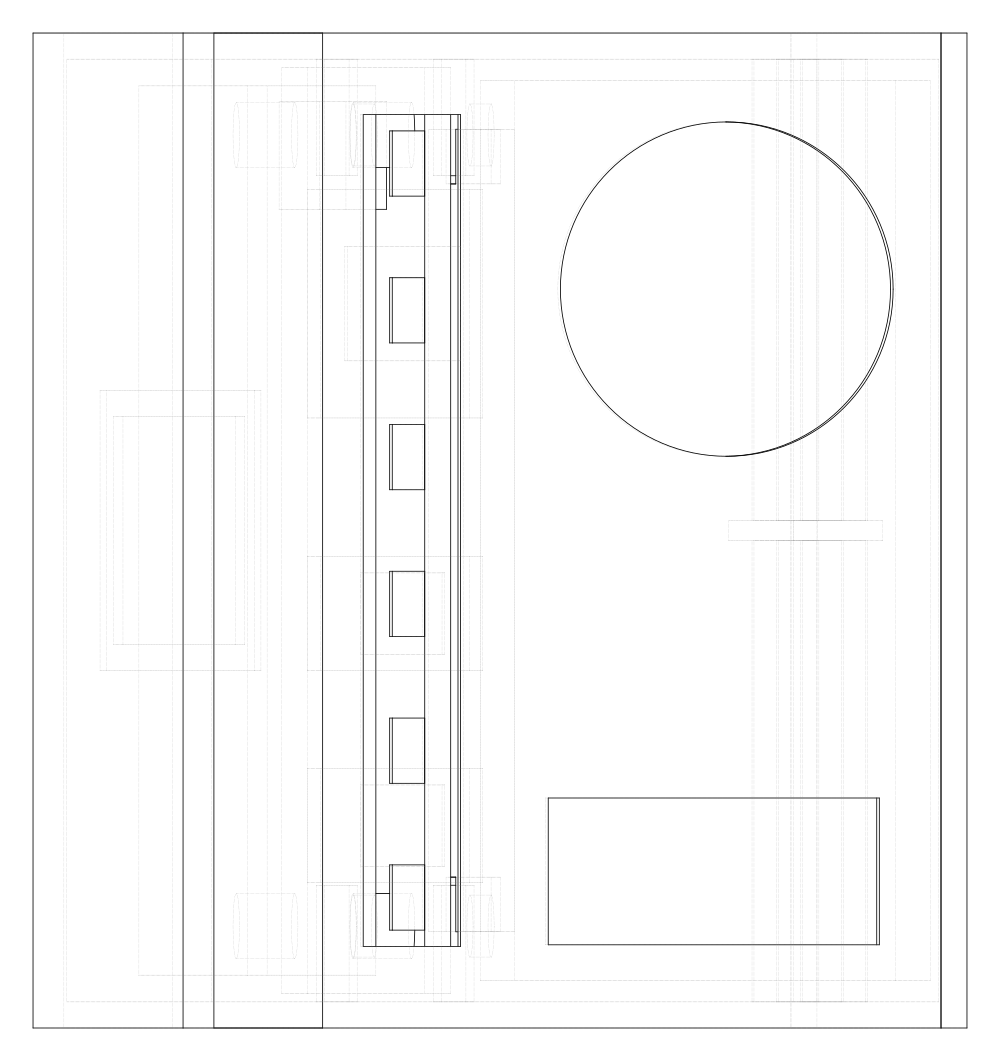
mech/out/concept-right.png
