metcalf/shop-exhaust-control/mech/out/concept-top.png

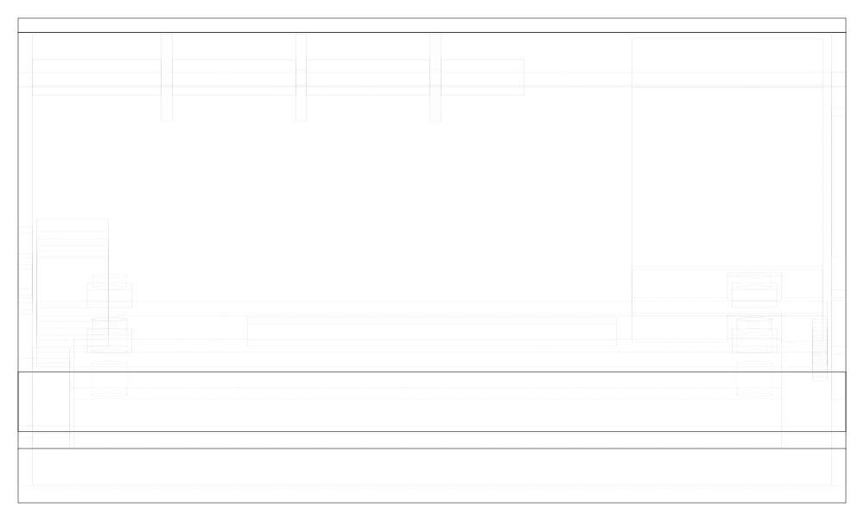
mech/out/concept-top.png
