metcalf/shop-exhaust-control/pcb/carrier/reports/placed-back.png

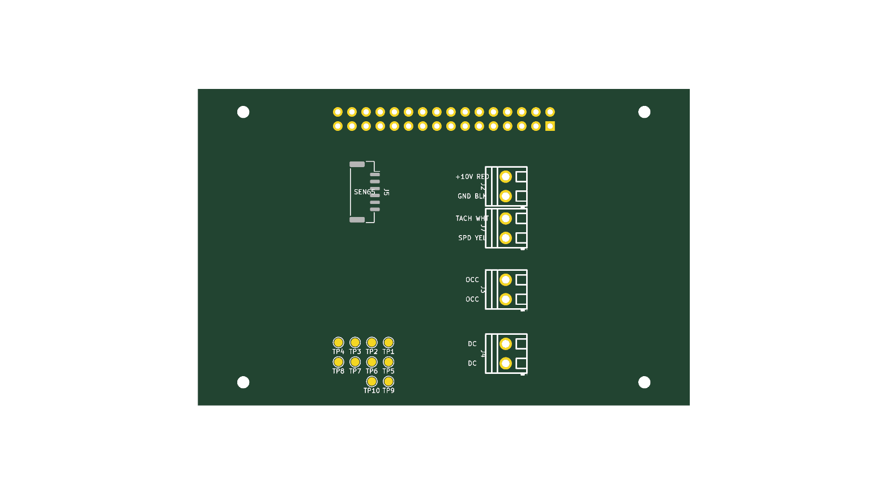
pcb/carrier/reports/placed-back.png
