metcalf/shop-exhaust-control/pcb/carrier/reports/placed-front.png

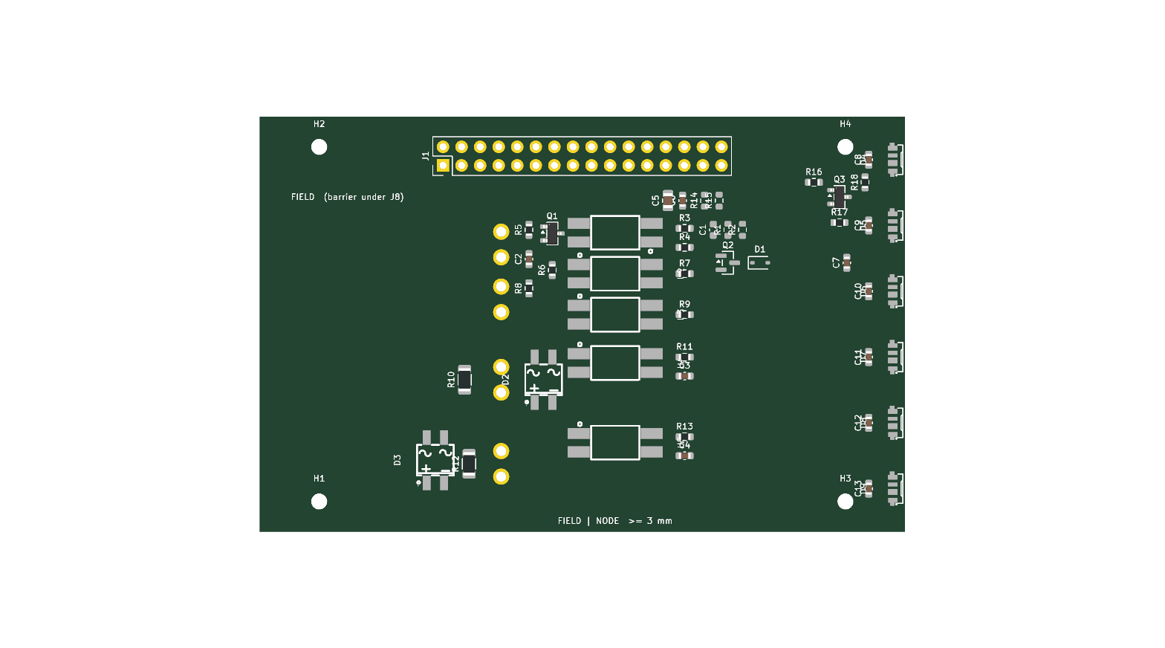
pcb/carrier/reports/placed-front.png
