metcalf/shop-exhaust-control/pcb/carrier/reports/bom-raw.csv

Reference | Value | Footprint | LCSC | DNP | QUANTITY
C1 | 2.2u | Capacitor_SMD:C_0603_1608Metric |  | DNP | 1
C2-C4,C7 | 1u | Capacitor_SMD:C_0603_1608Metric |  |  | 4
C5 | 10u | Capacitor_SMD:C_0805_2012Metric |  |  | 1
C6,C8-C13 | 100n | Capacitor_SMD:C_0603_1608Metric |  |  | 7
D1 | 1N4148WS | Diode_SMD:D_SOD-323 | C2128 | DNP | 1
D2,D3 | MB10S | exhaust:Bridge_MBS_MB10S | C2488 |  | 2
D4-D9 | SK6812SIDE-A | carrier:LED_SK6812SIDE-A_4.0x1.6mm | C5378721 |  | 6
H1-H4 | M2 | MountingHole:MountingHole_2.2mm_M2 |  |  | 4
J1 | Waveshare J8 2x16 pins | Connector_PinHeader_2.54mm:PinHeader_2x16_P2.54mm_Vertical |  | DNP | 1
J2-J4,J7 | KF128L-3.5-2P | exhaust:TerminalBlock_KF128L-3.5-2P | C474930 | DNP | 4
J5 | SM06B-GHS-TB | Connector_JST:JST_GH_SM06B-GHS-TB_1x06-1MP_P1.25mm_Horizontal | C133065 | DNP | 1
Q1 | AO3400A | Package_TO_SOT_SMD:SOT-23 | C20917 |  | 1
Q2 | 2N7002 | Package_TO_SOT_SMD:SOT-23 | C8545 | DNP | 1
Q3 | 2N7002 | Package_TO_SOT_SMD:SOT-23 | C8545 |  | 1
R1,R2 | 1M | Resistor_SMD:R_0603_1608Metric |  | DNP | 2
R3 | 390 | Resistor_SMD:R_0603_1608Metric |  |  | 1
R4,R6,R8,R16 | 10k | Resistor_SMD:R_0603_1608Metric |  |  | 4
R5 | 2.2k | Resistor_SMD:R_0603_1608Metric |  |  | 1
R7,R9 | 22k | Resistor_SMD:R_0603_1608Metric |  |  | 2
R10,R12 | 10k | Resistor_SMD:R_1206_3216Metric |  |  | 2
R11,R13 | 47k | Resistor_SMD:R_0603_1608Metric |  |  | 2
R14,R15 | 10k | Resistor_SMD:R_0603_1608Metric |  | DNP | 2
R17 | 1k | Resistor_SMD:R_0603_1608Metric |  |  | 1
R18 | 470 | Resistor_SMD:R_0603_1608Metric |  |  | 1
TP1 | GND | TestPoint:TestPoint_Pad_D1.5mm |  |  | 1
TP2 | +3V3 | TestPoint:TestPoint_Pad_D1.5mm |  |  | 1
TP3 | +5V | TestPoint:TestPoint_Pad_D1.5mm |  |  | 1
TP4 | FAN_PWM | TestPoint:TestPoint_Pad_D1.5mm |  |  | 1
TP5 | FAN_TACH | TestPoint:TestPoint_Pad_D1.5mm |  |  | 1
TP6 | FAN_PRESENT | TestPoint:TestPoint_Pad_D1.5mm |  |  | 1
TP7 | OCC_IN | TestPoint:TestPoint_Pad_D1.5mm |  |  | 1
TP8 | DC_IN | TestPoint:TestPoint_Pad_D1.5mm |  |  | 1
TP9 | IND_DRV | TestPoint:TestPoint_Pad_D1.5mm |  |  | 1
TP10 | PWRON | TestPoint:TestPoint_Pad_D1.5mm |  |  | 1
U1-U5 | LTV-817S-TA1-C | exhaust:SOP-4_LTV-817S_LS10.3 | C109227 |  | 5
