metcalf/shop-exhaust-control/mech/out/concept.step

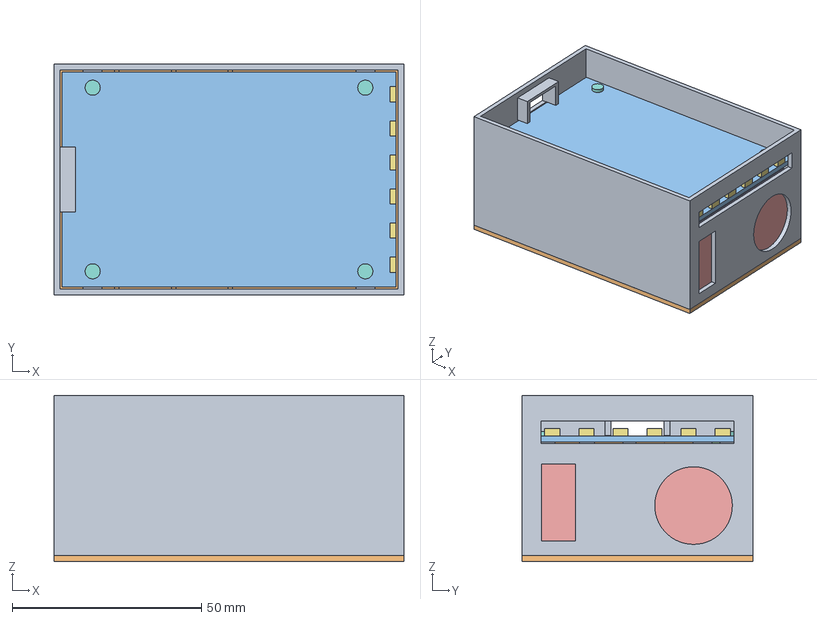
[picture p16: CAD file, 2026-11-12]
mech/out/concept.step
92.4 x 61.0 x 43.9 mm
