metcalf/shop-exhaust-control/mech/out/test-results.txt

....................                                                     [100%]
20 passed in 97.53s (0:01:37)
