metcalf/shop-exhaust-control/pcb/carrier/carrier-placed.kicad_pcb

## KiCad design pcb/carrier/carrier-placed.kicad_pcb (2026-11-12)

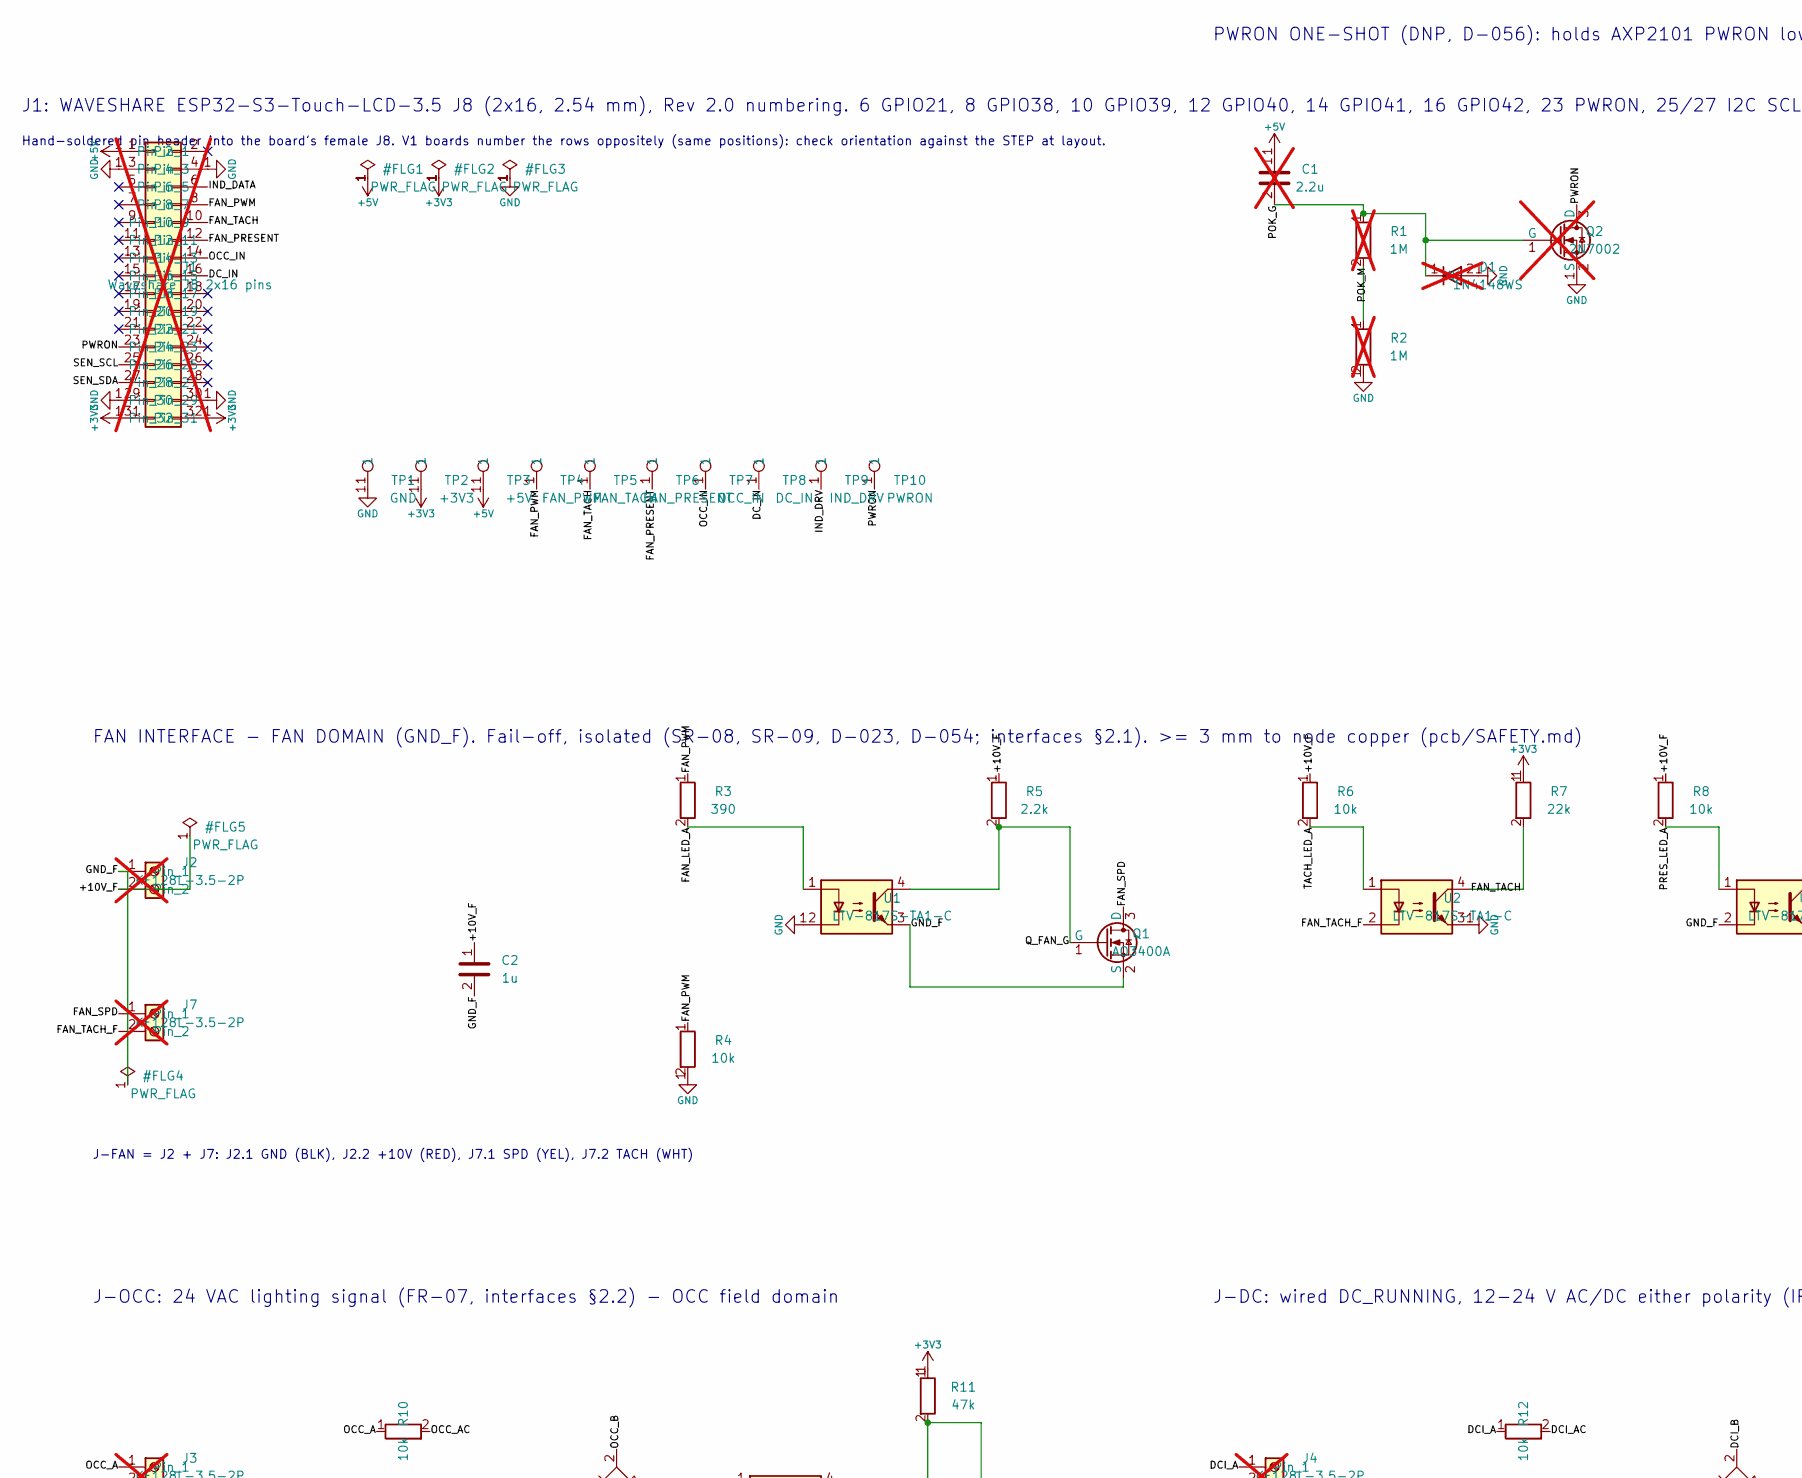
[picture p17: schematic carrier.kicad_sch, Shop exhaust carrier v1 (Waveshare 3.5), part in row 1, column 1]

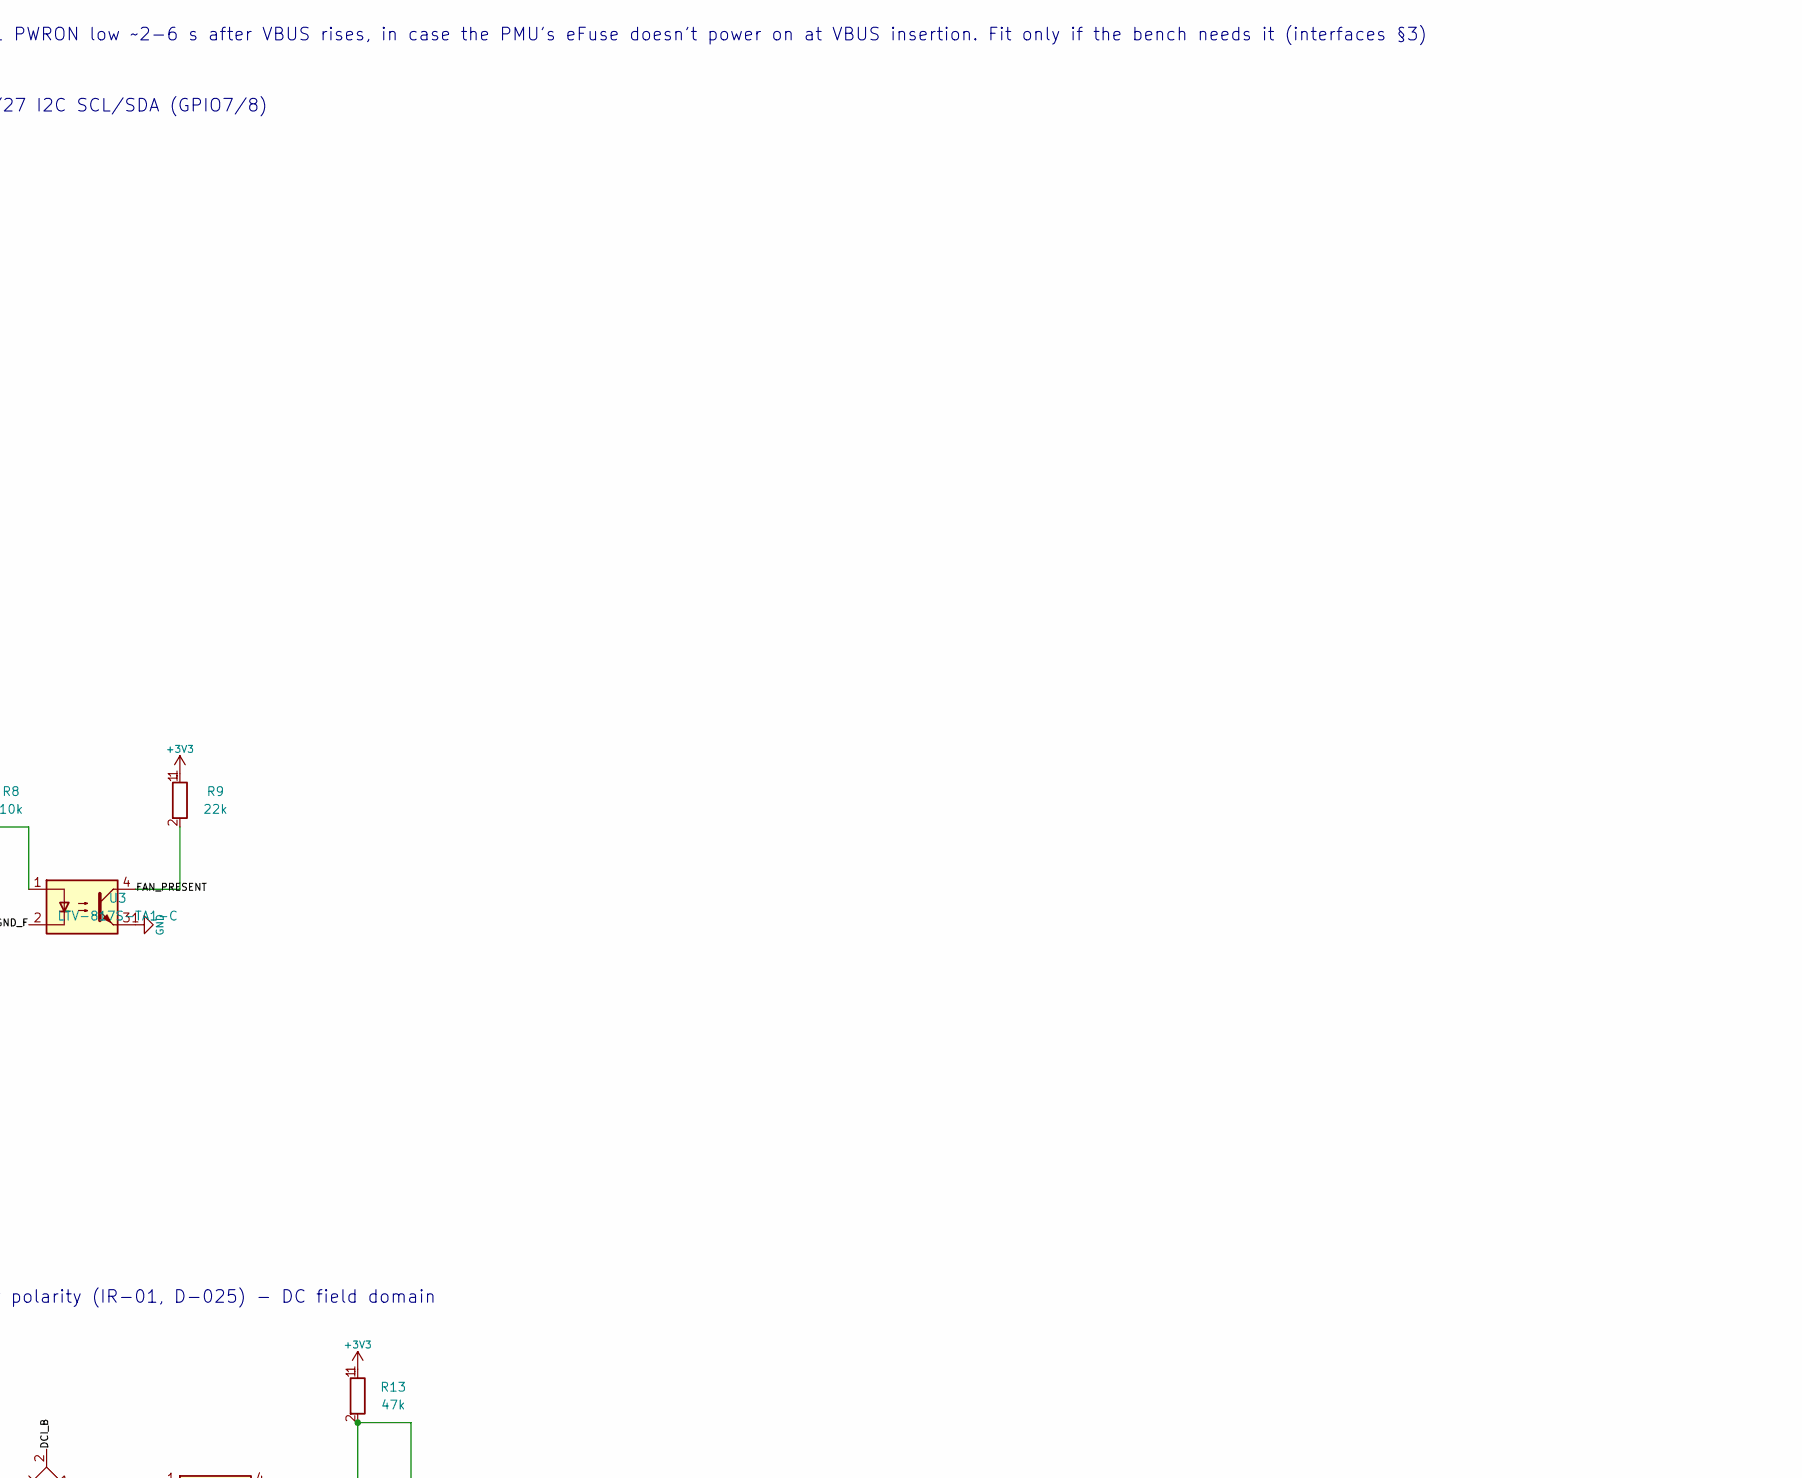
[picture p18: schematic carrier.kicad_sch, Shop exhaust carrier v1 (Waveshare 3.5), part in row 1, column 2]

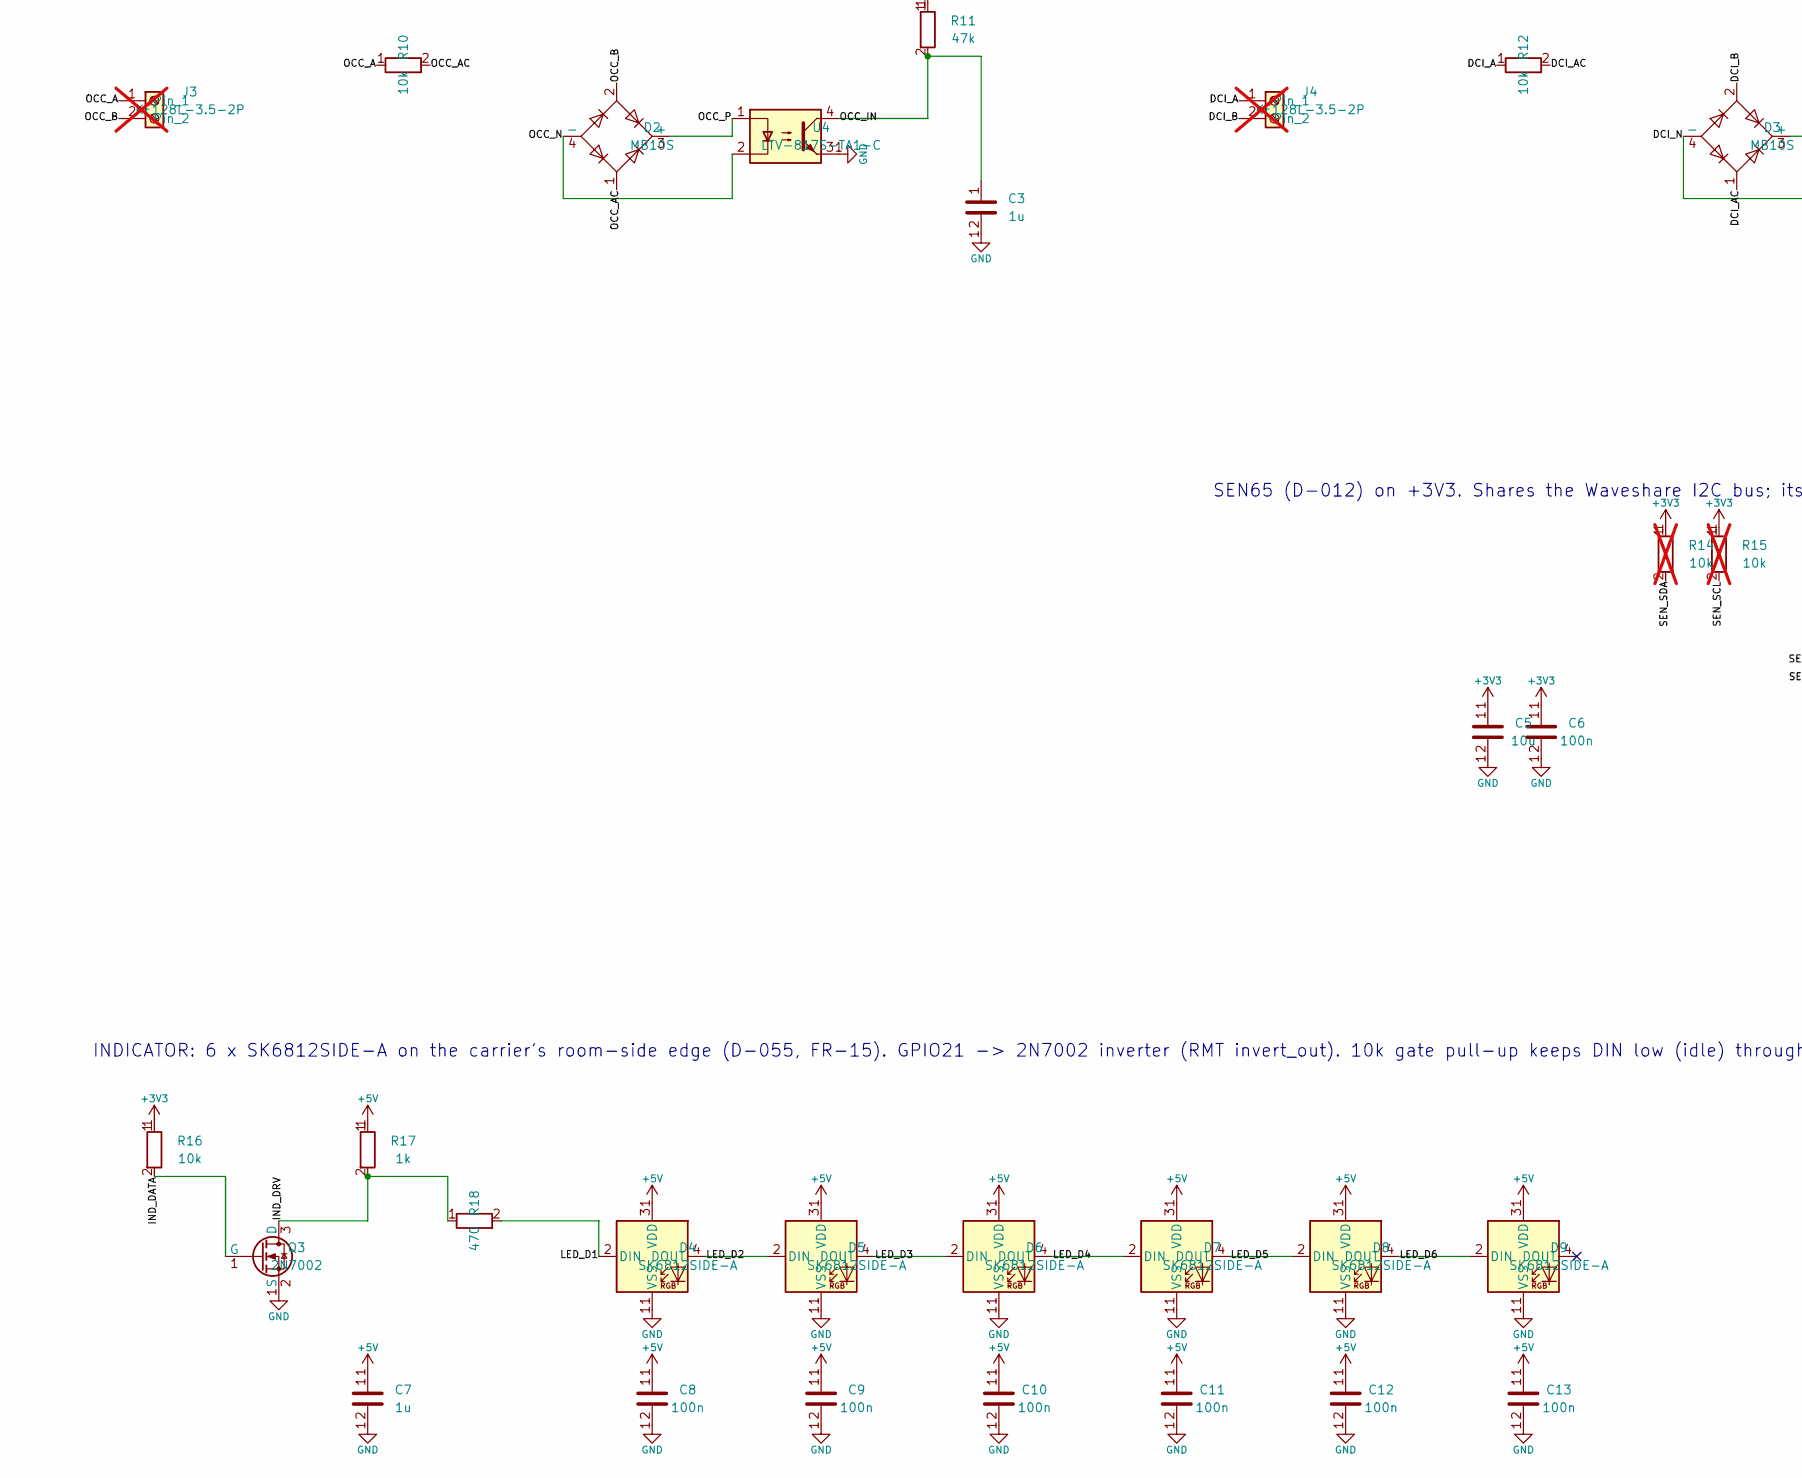
[picture p19: schematic carrier.kicad_sch, Shop exhaust carrier v1 (Waveshare 3.5), part in row 2, column 1]

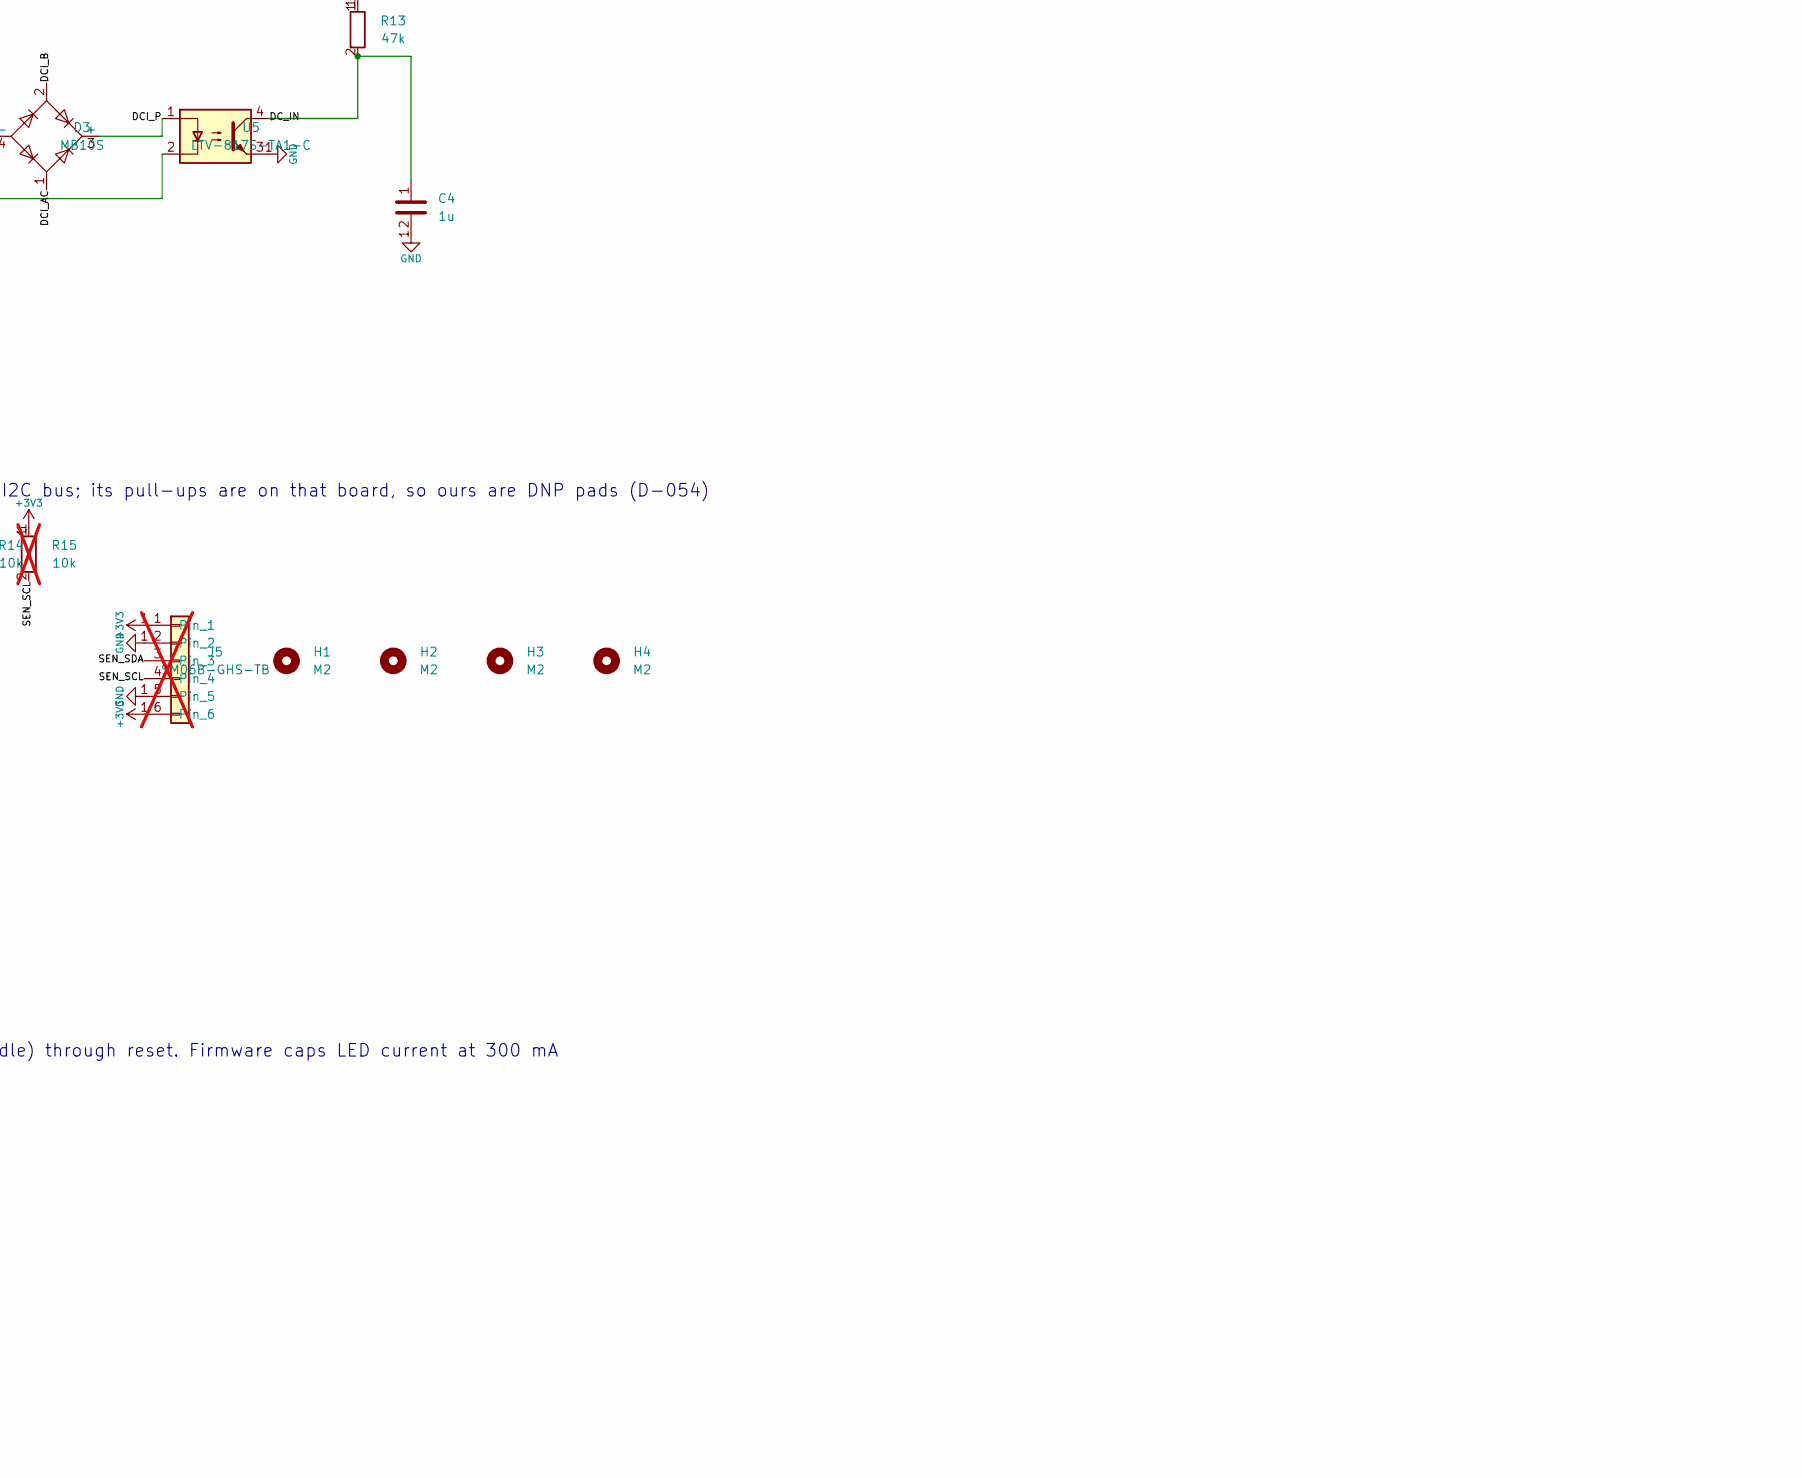
[picture p20: schematic carrier.kicad_sch, Shop exhaust carrier v1 (Waveshare 3.5), part in row 2, column 2]

Parts:
C1: 2.2u; C_0603_1608Metric; not fitted
C2, C3, C4, C7: 1u; C_0603_1608Metric
C5: 10u; C_0805_2012Metric
C6, C8, C9, C10, C11, C12, C13: 100n; C_0603_1608Metric
D1: 1N4148WS; D_SOD-323; LCSC C2128; not fitted
D2, D3: MB10S; Bridge_MBS_MB10S; LCSC C2488
D4, D5, D6, D7, D8, D9: SK6812SIDE-A; LED_SK6812SIDE-A_4.0x1.6mm; LCSC C5378721
H1, H2, H3, H4: M2; MountingHole_2.2mm_M2
J1: Waveshare J8 2x16 pins; PinHeader_2x16_P2.54mm_Vertical; not fitted
J2, J3, J4, J7: KF128L-3.5-2P; TerminalBlock_KF128L-3.5-2P; LCSC C474930; not fitted
J5: SM06B-GHS-TB; JST_GH_SM06B-GHS-TB_1x06-1MP_P1.25mm_Horizontal; LCSC C133065; not fitted
Q1: AO3400A; SOT-23; LCSC C20917
Q2: 2N7002; SOT-23; LCSC C8545; not fitted
Q3: 2N7002; SOT-23; LCSC C8545
R1, R2: 1M; R_0603_1608Metric; not fitted
R3: 390; R_0603_1608Metric
R4, R6, R8, R16: 10k; R_0603_1608Metric
R5: 2.2k; R_0603_1608Metric
R7, R9: 22k; R_0603_1608Metric
R10, R12: 10k; R_1206_3216Metric
R11, R13: 47k; R_0603_1608Metric
R14, R15: 10k; R_0603_1608Metric; not fitted
R17: 1k; R_0603_1608Metric
R18: 470; R_0603_1608Metric
TP1: GND; TestPoint_Pad_D1.5mm
TP2: +3V3; TestPoint_Pad_D1.5mm
TP3: +5V; TestPoint_Pad_D1.5mm
TP4: FAN_PWM; TestPoint_Pad_D1.5mm
TP5: FAN_TACH; TestPoint_Pad_D1.5mm
TP6: FAN_PRESENT; TestPoint_Pad_D1.5mm
TP7: OCC_IN; TestPoint_Pad_D1.5mm
TP8: DC_IN; TestPoint_Pad_D1.5mm
TP9: IND_DRV; TestPoint_Pad_D1.5mm
TP10: PWRON; TestPoint_Pad_D1.5mm
U1, U2, U3, U4, U5: LTV-817S-TA1-C; SOP-4_LTV-817S_LS10.3; LCSC C109227

Connections:
+3V3: C5.1, C6.1, J1.31, J1.32, J5.1, J5.6, R7.1, R9.1, R11.1, R13.1, R14.1, R15.1, R16.1, TP2.1
+5V: C1.1, C7.1, C8.1, C9.1, C10.1, C11.1, C12.1, C13.1, D4.3 (VDD), D5.3 (VDD), D6.3 (VDD), D7.3 (VDD), D8.3 (VDD), D9.3 (VDD), J1.1, R17.1, TP3.1
/+10V_F: C2.1, J2.2, R5.1, R6.1, R8.1
/DCI_A: J4.1, R12.1
/DCI_AC: D3.1, R12.2
/DCI_B: D3.2, J4.2
/DCI_N: D3.4 (-), U5.2
/DCI_P: D3.3 (+), U5.1
/DC_IN: C4.1, J1.16, R13.2, TP8.1, U5.4
/FAN_LED_A: R3.2, U1.1
/FAN_PRESENT: J1.12, R9.2, TP6.1, U3.4
/FAN_PWM: J1.8, R3.1, R4.1, TP4.1
/FAN_SPD: J7.1, Q1.3 (D)
/FAN_TACH: J1.10, R7.2, TP5.1, U2.4
/FAN_TACH_F: J7.2, U2.2
/GND_F: C2.2, J2.1, Q1.2 (S), U1.3, U3.2
/IND_DATA: J1.6, Q3.1 (G), R16.2
/IND_DRV: Q3.3 (D), R17.2, R18.1, TP9.1
/LED_D1: D4.2 (DIN), R18.2
/LED_D2: D4.4 (DOUT), D5.2 (DIN)
/LED_D3: D5.4 (DOUT), D6.2 (DIN)
/LED_D4: D6.4 (DOUT), D7.2 (DIN)
/LED_D5: D7.4 (DOUT), D8.2 (DIN)
/LED_D6: D8.4 (DOUT), D9.2 (DIN)
/OCC_A: J3.1, R10.1
/OCC_AC: D2.1, R10.2
/OCC_B: D2.2, J3.2
/OCC_IN: C3.1, J1.14, R11.2, TP7.1, U4.4
/OCC_N: D2.4 (-), U4.2
/OCC_P: D2.3 (+), U4.1
/POK_G: C1.2, D1.1 (K), Q2.1 (G), R1.1
/POK_M: R1.2, R2.1
/PRES_LED_A: R8.2, U3.1
/PWRON: J1.23, Q2.3 (D), TP10.1
/Q_FAN_G: Q1.1 (G), R5.2, U1.4
/SEN_SCL: J1.25, J5.4, R15.2
/SEN_SDA: J1.27, J5.3, R14.2
/TACH_LED_A: R6.2, U2.1
GND: C3.2, C4.2, C5.2, C6.2, C7.2, C8.2, C9.2, C10.2, C11.2, C12.2, C13.2, D1.2 (A), D4.1 (VSS), D5.1 (VSS), D6.1 (VSS), D7.1 (VSS), D8.1 (VSS), D9.1 (VSS), J1.3, J1.4, J1.29, J1.30, J5.2, J5.5, Q2.2 (S), Q3.2 (S), R2.2, R4.2, TP1.1, U1.2, U2.3, U3.3, U4.3, U5.3

Notes on the sheet:
J1: WAVESHARE ESP32-S3-Touch-LCD-3.5 J8 (2x16, 2.54 mm), Rev 2.0 numbering. 6 GPIO21, 8 GPIO38, 10 GPIO39, 12 GPIO40, 14 GPIO41, 16 GPIO42, 23 PWRON, 25/27 I2C SCL/SDA (GPIO7/8)
Hand-soldered pin header into the board's female J8. V1 boards number the rows oppositely (same positions): check orientation against the STEP at layout.
PWRON ONE-SHOT (DNP, D-056): holds AXP2101 PWRON low ~2-6 s after VBUS rises, in case the PMU's eFuse doesn't power on at VBUS insertion. Fit only if the bench needs it (interfaces §3)
FAN INTERFACE - FAN DOMAIN (GND_F). Fail-off, isolated (SR-08, SR-09, D-023, D-054; interfaces §2.1). >= 3 mm to node copper (pcb/SAFETY.md)
J-FAN = J2 + J7: J2.1 GND (BLK), J2.2 +10V (RED), J7.1 SPD (YEL), J7.2 TACH (WHT)
J-OCC: 24 VAC lighting signal (FR-07, interfaces §2.2) - OCC field domain
J-DC: wired DC_RUNNING, 12-24 V AC/DC either polarity (IR-01, D-025) - DC field domain
SEN65 (D-012) on +3V3. Shares the Waveshare I2C bus; its pull-ups are on that board, so ours are DNP pads (D-054)
INDICATOR: 6 x SK6812SIDE-A on the carrier's room-side edge (D-055, FR-15). GPIO21 -> 2N7002 inverter (RMT invert_out). 10k gate pull-up keeps DIN low (idle) through reset. Firmware caps LED current at 300 mA

Board: 2 copper layers, 68 parts (15 on the bottom side), 39 nets, no tracks yet.
