metcalf/shop-exhaust-control/(commit log)

2026-10-24 Revise project setup after review with Andrew
    Firmware is bare ESP-IDF (C++) on the shared metcalf/esp-iot-core stack,
    with control logic host-tested in C++ instead of a Python model (D-007).
    v1 uses a custom PCB with third-party assembly; mains on the board is
    allowed under documented IEC 62368-1 spacing rules, and the enclosure has
    no DIN-rail constraint (D-008).
    Controls are physical but not necessarily analog: proposed Auto/holds/
    scenes on an encoder, buttons and small display, plus an ambient air-
    quality indicator. Fan speed goes through the CLOUDLINE PRO S6 control
    port, with mains switching only if Q-15 shows it's needed.
    Process: costly decisions are made and flagged for review r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
2026-10-24 Requirements review updates; prune survey and open questions
    - D-009: occupancy-based Auto with a ventilation floor; encoder plus ~4
    unlit configurable buttons. FR-02/FR-07 revised, FR-03 and FR-16
    dropped, FR-17 added. HA read-only for v1. Q-17 answered.
    - interfaces.md: panel buttons match D-009.
    - site-survey.md: remove items already answered in the repo and items
    duplicated in open-questions.md, so each question is answered once.
    - open-questions.md: close Q-02 (DC recirculates) and Q-06 (24 VAC
    lighting signal) from existing docs; Q-14 notes KiCad not installed.
2026-10-24 Propose PCB/electrical toolchain (D-010)
    Choose tools that turn Claude's weak areas (pin mapping, sheet placement,
    layout) into scripted, checkable steps: kiutils + easyeda2kicad for the
    schematic, rendered images and netlist assertions for verification, KiCad 9
    creepage DRC for mains spacing, and Freerouting vs Quilter layout candidates
    from a locked placement. Logged as proposed pending Andrew before phase 3.
2026-10-24 Propose mechanical toolchain (D-011); switch CadQuery to build123d
    build123d's explicit locations avoid the silent wrong-face errors of
    CadQuery's string selectors, and no mech code exists yet. Models are checked
    by headless renders and pytest geometry/interference tests, with positions
    read from the KiCad board. Enclosure is outsourced PA12 (MJF/SLS); since
    standard PA12 isn't flame-rated, Q-18 asks how to handle any mains inside.
2026-10-25 NFR-04: scope dust protection to the electronics compartment
    IP5X can't apply to an enclosure that has to admit air to the PM sensor.
    Require a sealed electronics compartment with the sensor flow path kept
    outside it, designed to IP5X intent rather than claimed or tested.
2026-10-25 NFR-04: extend the exposed sensor bay to the VOC and coarse dust sensors
2026-10-25 Phase 1: draft requirements for G1 from the completed site survey
    Apply Andrew's answers (Q-03..Q-18) and survey findings. Requirements now
    have a site summary, acceptance criteria for every requirement, and a
    parameter table with sourced initial values so the logic can be host-tested
    before commissioning.
    Survey showed the fan's 120 V is switched by the lighting relay, which would
    prevent vacant clear-down and Spray run-on; proposed D-013 un-switches it
    (needs Andrew, G3). Also D-012 (SPS30 + SGP41 in v1), D-014 (panel above the
    miter station), new questions Q-19..Q-21 (rewire, vacant sensor-fault
    behavior, budget realism), and two process notes for the DC project.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
2026-10-25 Apply Q-15/19/20/21 answers; fan-port fail state and isolation; drop walk-in delay
    - Q-15 port measurements: 5 kHz open-drain PWM against the fan's +10 V
    pull-up; unplugged = full speed. SR-08 now sets the fail states (node
    unpowered = full, boot = off). New SR-09 isolates the fan port because its
    relation to mains is unknown.
    - Q-19: an unswitched receptacle exists, so D-013 is accepted with no rewiring.
    - Q-20: vacant with a PM sensor fault means off; occupancy lags 15 min (Lutron).
    - Q-21: $300 ceiling; aim for JLCPCB Economic PCBA (NFR-05).
    - P-02 dropped at Andrew's request: the floor starts with occupancy.
    - FR-08/AC-10: measure VOC pickup from downstream spraying instead of
    as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
2026-10-25 FR-19: cap Auto speed and runtime while vacant
    Andrew asked for a maximum unoccupied runtime/speed. Caps guard against a
    fouled sensor or persistent source running the fan indefinitely, and surface
    that case as a 'clear-down incomplete' notice. Spray keeps full speed through
    its minimum run-on; explicit holds are exempt.
2026-10-25 FR-05: frame clear-down sampling as a tunable sensor-life vs overrun trade-off
    Andrew: 'overrun by one interval' isn't a standard to meet, it's one point on
    a trade-off. Add P-23 (overrun target) and have AC-03 report the trade-off
    curve so the value is chosen from data at commissioning.
2026-10-26 Move controller to the north end; BLE advertising for the DC link
    Air flows south to north the length of the shop, so a mid-shop sensor would
    miss the lathe, north bench and nearby spraying. D-015 (replaces D-014) puts
    panel, indicator and sensors at the exhaust end, out of the hood's capture
    zone. That makes a DC wire a separate run, so D-016 uses BLE advertising for
    DC_RUNNING with a 10 s timeout (P-24), and no wired or MQTT path, per Andrew.
    Single vs. separate DC panel is deferred to the DC project; the message
    format leaves room for it. Q-23 asks for the exact spot. Process note: map
    airflow before choosing sensor locations.
2026-10-26 Q-23: under-cabinet mount at the north wall, under 10 ft of cable
    IR-04 cable length 10 ft; NFR-09 keeps the sensor bay at least 3 ft from the
    hood with its inlet facing the room, since the hood intake is in the same
    plane as the cabinet bottoms.
2026-10-26 Coarse dust sensor into v1; add SHT4x for VOC compensation
    Andrew wants to compare sensor behavior on real traces, so the Sharp-class
    coarse sensor runs continuously and is logged next to the SPS30; its control
    use (FR-17) sits behind a flag that starts off until commissioning data
    supports it. SHT4x added for SGP41 humidity compensation (FR-20). HA
    publishes all raw sensor channels.
2026-10-26 Fail-off when the node is unpowered; drop runtime parameters; continuous fan duty
    SR-08 (Andrew): fan held off with the node unpowered or booting, so the
    hold-off is powered from the fan side of the isolation barrier. NFR-10
    dropped: P-nn values compiled in and changed by OTA. FR-10: duty is
    continuous, not stepped.
2026-10-26 Budget hook: wrap up via STATE.md and the end-of-session steps, not PROGRESS.md
    PROGRESS.md wasn't used anywhere else, so sessions cut short by the usage
    budget left state in a different file from sessions that ended normally.
    Claude-Session: https://claude.ai/code/session_01AhzsjsaoU1Q4NzgYdhjv5A
2026-10-26 Q-24: build around a single SEN65; drop coarse sensor and SHT4x
    One module, one airflow path (Andrew). No gas-only mode is acceptable since
    PM sampling only goes sparse when the fan is already high. New constraints:
    the VOC baseline must survive module sleep (FR-14, AC-28), and the module
    sleeps through Spray's minimum run-on to avoid overspray fouling (FR-08).
    A module fault now drops PM and VOC together (SR-04).
2026-10-26 Nightly: run interactive Claude in tmux so the statusline keeps usage.json current
    Under -p the statusline doesn't run and stream-json reports usage only once,
    so the budget hook couldn't see usage climb mid-run. Now nightly.sh starts
    interactive Claude in a detached tmux on its own socket; a Stop hook gated on
    SHOP_NIGHTLY closes it when Claude ends its turn, and a watchdog caps the run.
    Budget hook: the once-only flag is now per session, not per day, so a daytime
    warning no longer silences the nightly run's.
    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
2026-10-26 Phase 2: G2 architecture draft (architecture, control logic, interfaces)
    G1 is recorded and the nightly schedule was treated as the phase 2 start.
    - docs/architecture.md: block diagram, partitioning (no mains anywhere),
    firmware layout and tasks, mechanical concept, failure modes,
    traceability, cost estimate (~$265 against the $300 ceiling)
    - docs/control-logic.md: state machine spec for exhaust_logic (modes,
    AutoDemand, sampler with an overrun-bounded clear-down rule, faults,
    output shaping, C-nn design constants, host-test plan)
    - docs/interfaces.md: BLE DC payload v1.0, GPIO plan, fan-powered fail-off
    isolated fan interface, power budget, HA entities, mechanical interfaces
    - Dec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
2026-10-26 Apply Q-25 and Q-28 answers ahead of the G2 review
    Q-28: Auto press and new holds/scenes override Spray and its run-on
    (no long-press, no refusal); a sensor fault drops only PM/VOC demand
    (P-19 dropped); fan_port fault written into FR-18; keep a wired
    opto-isolated DC_RUNNING backup input, used for AC-06 (D-024, D-025).
    Q-25: fan cable hard-wired into a 4-pos terminal, no USB-C (D-026).
    Also raise the 24 VAC input TVS to >= 40 V standoff (36 V clipped the
    37 V peak at +10 % line).
    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
2026-10-26 G2 review: fix B-3 (high PM is saturation, never a sensor_range fault); queue B-1/B-2 as Q-29/Q-30
    Reviewer output in reviews/G2-review.md (3 blocking, 17 should-fix,
    19 notes). B-1 amends NFR-07 and B-2 needs the Q-22 measurement, so
    both go to Andrew.
    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
2026-10-29 Apply Q-29/Q-30/Q-22 and S-1; triage G2 review; G2 ready for sign-off
    D-027: holds/scenes resume after non-power resets via RTC memory
    (amends NFR-07, AC-18), resolving B-1. D-028: fan port treated as SELV
    on measured evidence, basic barrier kept, Q-31 loaded check before
    layout; fan power-up burst accepted (S-1), resolving B-2. S-14 boot
    config into the phase 3 verify list; S-17 TVS to 48 V standoff.
    Should-fix items split into hardware-now and a firmware backlog, per
    Andrew's process note (recorded in process-notes).
    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
2026-10-29 Display: 2.8" IPS, no touch (D-022 amended)
    Same 240x320 resolution, larger pixels for reading from below an
    under-cabinet mount. IPS required for the viewing angle; touch skipped.
    Power budget and cost estimate updated.
    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
2026-10-29 Phase 3 order: schematic and priced parts list before layout, mech, firmware (D-029)
    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
2026-10-29 Power: single external 5 V USB-C for power and flash/log, 3.3 V only (D-030)
    Drops the 12 V barrel input, 12->5 V buck, reverse-polarity FET and
    VBUS OR-ing; sensor rail becomes a P-FET load switch off 3.3 V.
    Supersedes D-020 (internal USB), amends D-018 and NFR-04 (USB-C mouth
    excepted from the IP5X intent, per Andrew).
    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
2026-10-29 Indicator: plain RGB short strip; keep SEN65 load switch for recovery (D-031)
    Drops WS2812B and the level shifter; R/G/B on LEDC via three N-FETs.
    Applies G2 review S-13 (pull-ups on the switched rail, hi-Z before
    power-off, bleed) and fixes SEN_PWR_EN polarity for the P-FET switch.
    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
2026-10-29 Drop the illuminated-encoder option (D-031)
    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
2026-10-29 Field wiring: fixed screw terminals instead of pluggable (D-032)
    Wired once at install; a plug can't pass back through its cable gland,
    so pluggable saved nothing on removal.
    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
2026-10-29 Note fan PWM findings from the rollitup Cloudline thread; keep H11L1
    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
2026-10-29 Apply Q-31, Q-26, Q-27: port confirmed SELV, port current fits, fridge-panel mount proposed
    Q-31: ~60 uA into 10k, well under ES1 (D-028 confirmed). Q-26: stock
    controller draws ~9.3 mA from +10 V, so the fail-off budget is within
    demonstrated capacity (D-023). Q-27: Andrew proposes the refrigerator
    side panel beside the hood; D-033 proposed, Q-32 for measurements and
    the NFR-09 distance.
    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
2026-10-29 Mount on the refrigerator side panel beside the hood (D-033)
    Q-32: ~18" from the hood edge, center ~60" up, sensor inlet ~2 ft from
    the hood facing the room. NFR-09 distance and IR-04 location amended;
    enclosure becomes a wall-cleat mount (D-019). Kids' workbench below:
    panel lock added to the firmware backlog.
    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
2026-10-29 Sensor inlet on the bay's room-side end, not facing down (D-033)
    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
2026-10-29 Phase 3: PCBA vendor check, KiCad 10 toolchain, generated schematic with ERC and netlist checks
    - sourcing/pcba-vendor.md: ESP32-S3 module is JLC 'Standard Only', so PCBA on
    Standard single-sided (D-034); sourcing notes for isolation, power, UI parts
    - pcb/tools/kicad-cli: repo-local config dir (kicad-cli hangs in the sandbox
    without one); kiutils reads KiCad 10 libs (D-035)
    - pcb/gen: schematic-as-code generator, netlist assertions for isolation
    domains, fail-off pulls and the GPIO plan; ERC clean, assertions pass
    - pcb/design.md: values and worst cases for G2 review S-2, S-5, S-14;
    pcb/SAFETY.md: isolation domains and every barrier crossing (S-4)
    - D-036 bridge + PC817C inputs, D-0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
    [bom-raw.csv, exhaust.kicad_sch]
2026-10-29 Priced parts list and D-029 checkpoint; SEN6x pinout confirmed; part consolidation
    - sourcing/priced-parts.md (generated on-board table via pcb/gen/price.py):
    board ~$156 for 2 assembled, total ~$276-352 against the $300 ceiling
    - Stocked substitutes: FB divider 100k/22k (453k unavailable), 100 nF debounce
    (10 nF Basic out of stock), AO3400A for Q_FAN, 0603 1 uF 50 V for +10V_F
    - SEN6x connector pinout confirmed from the datasheet (O-1 closed)
    - Q-33..Q-36 for Andrew: layout go-ahead, SEN65 stock, display module, cable reach
    - STATE: stopped for Andrew per D-029; process notes from the night
    Claude-Session: https://claude.ai/code/s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
    [bom-raw.csv, exhaust.kicad_sch]
2026-10-30 Q-33 assembly-route costing, Q-35 display proposal (MSP2833), apply Q-34/Q-36
    Andrew asked what hand-soldering the module (Economic) or full DIY assembly
    would save, and for a generic 2.8" display proposal. No 2.8" ST7789 generic
    has an IPS datasheet; the LCDwiki MSP2833 (ILI9341V) does. Q-34 (SEN65 at
    Mouser) and Q-36 (own supply) drop the total to ~$266-296.
    Claude-Session: https://claude.ai/code/session_01EWKJFLJEPi6jTykEoYPxcu
2026-11-09 Schematic generator: draw wires within blocks, power symbols for rails (D-038)
    Andrew found the label-per-pin sheet hard to follow in review. Pins on the
    same net within a block are now joined by routed wires, one label per group;
    GND/+3V3/+5V use power symbols. Netlist identical before/after (94 nets),
    ERC 0, netlist assertions pass.
    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
    [exhaust.kicad_sch]
2026-11-09 Ignore KiCad local history directories
    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
2026-11-09 Remove VBUS_SENSE, leave GPIO2 spare (D-039)
    The sense only guarded a bench-only weak-port case, and its 4.6 V
    threshold sits within measurement error of normal +5V on the installed
    3 m cable, so it could dim the indicator on the correct adapter.
    Removes the divider and filter cap. ERC 0, netlist assertions pass.
    Claude-Session: https://claude.ai/code/session_01EWKJFMC947aKvnhaTAE16t
    [bom-raw.csv, exhaust.kicad_sch]
2026-11-09 Drop VBUS polyfuse, limit +5V to 10 uF, use AP63203 buck (D-040)
    The source owns overcurrent protection, and F1 cost margin at the
    1.1 A peak. A non-PD USB sink is limited to 1-10 uF, so the proposed
    bulk cap was out and the existing second 10 uF had to go. The hot-plug
    risk is handled at the part: AP63203 is rated 35 V against the
    SY8089's 6 V. Closes O-4. ERC 0, netlist assertions pass, including
    new ones for the capacitance limit and buck wiring.
    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
    [bom-raw.csv, exhaust.kicad_sch]
2026-11-09 Replace EN/BOOT switches with screwdriver pad pairs (D-041)
    The switches only serve setup and recovery. Each signal gets its own
    adjacent GND pad so two screwdrivers can short BOOT and tap EN in
    sequence, without holding a short while plugging in USB. ERC 0,
    netlist assertions pass, including new ones for the pads.
    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
    [bom-raw.csv, exhaust.kicad_sch]
2026-11-09 Set EN/BOOT pad pairs to minimum copper clearance (D-041)
    A tighter gap makes the pairs easier to bridge with a screwdriver.
    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
2026-11-09 Remove TVS diodes from the fan lines (D-042)
    The cable's only source is the fan's 10 V, below their 18.5 V
    breakdown, so they never helped with mis-termination, and on reversed
    polarity they short the fan's supply. The stock controller has none
    on the same port. ERC 0, netlist assertions pass.
    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
    [bom-raw.csv, exhaust.kicad_sch]
2026-11-09 Remove tach series diode, keep separate presence opto (D-043)
    The fan's tach is open drain, so white never rises above our pull-up,
    and even a 10 V push-pull output stays inside the PC817's 6 V reverse
    limit. Two optos stay so presence doesn't depend on how a given fan's
    tach rests when stopped. ERC 0, netlist assertions pass.
    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
    [bom-raw.csv, exhaust.kicad_sch]
2026-11-09 Run the fan interface from +10V_F, remove the HT7550 (D-044)
    The H11L1 operates up to 15 V and red measures about 10 V, so the fan
    side doesn't need a 5 V rail. Q1's gate pull-up and the tach and
    presence LED feeds move to +10V_F through 10 k, and the tach LED feed
    doubles as white's pull-up. ERC 0, netlist assertions pass.
    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
    [bom-raw.csv, exhaust.kicad_sch]
2026-11-09 Swap optos to LTV-817S-TA1-C, add I2C test pads (D-045)
    C109227 is a C-rank Basic part from Lite-On with a published UL file,
    replacing the Extended PC817C-S at about $0.045 more each. SEN_SDA and
    SEN_SCL get test pads for probing. ERC 0, netlist assertions pass,
    including new ones for the pads.
    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
    [bom-raw.csv, exhaust.kicad_sch]
2026-11-09 Use 80 % typical CTR at 1 mA for opto margins (D-045)
    Andrew read the figure from the Lite-On curve. It replaces the assumed
    100 % in the tach, presence and field-input margins.
    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
2026-11-09 Remove TVS diodes from J-OCC and J-DC (D-046)
    Each input already has 5.4 k in series, a 1 kV bridge and a 5 kV opto,
    so the TVS only mattered for a large surge coupled through the
    transformer. J-DC has nothing connected yet. ERC 0, netlist assertions
    pass.
    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
    [bom-raw.csv, exhaust.kicad_sch]
2026-11-09 Remove the SEN65 power switch (D-047)
    The switch was precautionary: no SEN5x/SEN6x report found needed a
    module power cycle, and a hang only drops PM/VOC demand under SR-04.
    The sensor and I2C pull-ups move to +3V3 and GPIO10 becomes a spare.
    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
    [bom-raw.csv, exhaust.kicad_sch]
2026-11-10 Switch to a touch-only panel on the DLS29028B (D-048)
    Andrew chose to avoid the mechanical work of physical controls. Removes
    the encoder, four buttons and backlight FET, and moves J6 to a 1x14
    socket on +5V for the Elecrow DLS29028B (MSP2834). Touch gets its own
    I2C bus with two 2N7002 shifters, because the module pulls CTP SCL/SDA
    to VCC. Answers Q-35.
    The physical-controls design is recorded in
    docs/physical-controls-record.md for later revisions or the DC project.
    ERC 0 violations; netlist assertions pass.
    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
    [bom-raw.csv, exhaust.kicad_sch]
2026-11-10 Close O-6 against the ESP32-S3 datasheets: GPIO47/48 are 3.3 V on the N16R8
    Adds sourcing/gpio47-vdd-spi.md with citations. Drops the open-drain backlight
    note, which relied on undocumented pad clamps; push-pull is fine at 3.3 V.
    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
2026-11-10 Split J-FAN into two 2-pos terminals; one 10 k on the AC inputs (D-049)
    Drops two unique Extended parts: the 4-pos XY350V becomes two KF128L
    blocks (J2 + J7) already used for J-OCC/J-DC, and each AC input's
    2 x 2.7 k 1206 becomes a single Basic 10 k 1206. Regenerated the
    schematic: ERC 0 violations, netlist assertions pass. design.md §3
    worst cases redone for 10 k (12 VDC margin ~8x, 70 mW at 26.4 VAC);
    priced parts refreshed (2-board PCBA ~$133, 28 unique parts).
    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
    [bom-raw.csv, exhaust.kicad_sch]
2026-11-10 Keep the fan-side opto barrier (D-050)
    Andrew chose to keep U4-U6. Logs the alternatives so they don't come
    back on the DC project: non-isolated FETs (~$4 on 2 boards, but fan
    common-mode noise on node ground risks the touch panel), a ferrite
    in fan GND (no effect at 60 Hz or in the touch band), and capacitive
    coupling (passes the noise, can't carry DC or 0/100 % PWM).
    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
2026-11-10 Record schematic approval (Q-33): layout unblocked
    Andrew approved the schematic and priced list, passing the D-029
    checkpoint. Q-33's stated defaults apply: route-agnostic layout with no
    EPAD back-solder vias, route picked at G4 from a live quote, MJF
    enclosure. STATE now points the nightly run at layout first.
    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
2026-11-10 Mark D-010 (PCB/electrical toolchain) accepted
    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
2026-11-10 Start layout (D-010): checked footprints, locked placement, barrier DRC
    The schematic is now the source (D-035): pcb/exhaust.kicad_sch is edited
    directly, pcb/gen/build.py is frozen, and pcb/gen/run.sh only regenerates
    with REGENERATE=1.
    - Footprints checked against the LCSC drawings and datasheets (O-3, O-5
    closed; D-051). Project library pcb/lib/exhaust.pretty. The 3528 RGB and
    MB10S are renumbered: the stock LED map put +5 V on a cathode. Module
    EPAD vias and the 48 x 21 mm keepout are removed (Q-33).
    - Scripted, locked placement in pcb/exhaust-placed.kicad_pcb (Quilter
    input): 72 x 123 mm, display on J6 with shared mounting holes, field
    terminals on top, antenna out the left e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
    [bom-raw.csv, exhaust-placed.kicad_pcb, exhaust.dsn, exhaust.kicad_sch]
2026-11-10 Evaluate Waveshare ESP32-S3-Touch-LCD-2.8B in place of the custom PCB (D-053 proposed)
    Pin map from the vendor schematic and demo: GPIO16 is touch INT (wiki says spare),
    SEN65 clashes with the on-board QMI8658 at 0x6B. Usable: 43/44, 4 (lift R24), 0 (out).
    Fail-off needs a relay NC contact; PC817 modules alone fail full-speed.
    Q-40..Q-43 for Andrew; layout paused.
    Claude-Session: https://claude.ai/code/session_01EWKJFJs5GyzsRRhoGfHvVe
2026-11-10 Cost route B: Waveshare board + minimal carrier PCB (D-054 proposed)
    Carrier keeps the D-023 fail-off fan interface, all inputs (PCA9536 for slow ones),
    TCA9543A for the SEN65/QMI8658 0x6B clash, off-board LED strip. Live JLC check:
    all S3 modules are Standard Only, every carrier part is Economic-eligible.
    Electronics ~$65-100/unit vs ~$144. Q-40 reframed as route A/B/C; Q-44, Q-45.
    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
2026-11-10 Accept D-054 with Andrew's cuts: LTV-817 PWM, desolder IMU, lift R24
    Route B (Waveshare + carrier). FAN_PRESENT and DC_IN dropped (no expander), so
    D-025 reverts. Carrier is all Basic/Economic parts. Fan-side budget ~5.4 mA with
    the 2.2k gate pull-up; fail-off unchanged. Q-38/39/40-44 closed; next: requirements
    amendments, interfaces/architecture rewrite, carrier schematic.
    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
2026-11-10 Indicator: on-board side-view SK6812SIDE-A on the carrier (Q-45, D-055)
    Andrew chose on-board addressable LEDs over an off-board strip. SK6812SIDE-A
    (C5378721) is documented side-light and Economic-eligible; XL-0807 was
    wrongly called side-emitting. Adds the carrier's one Extended part.
    Display stays 480x640 with a stress test queued in the bench plan.
    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
2026-11-10 Amend requirements, interfaces and architecture for route B (D-054, D-055)
    FR-18 loses the fan-port fault, IR-01/AC-06 go BLE-only, panel and USB-C
    move to the Waveshare board. Interfaces §2 rewritten with the J7 pin map
    read from the Waveshare schematic, LTV-817 fail-off stage, carrier power.
    Architecture cost re-estimated at ~$215.
    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
2026-11-10 Carrier schematic for the Waveshare 2.8B (D-054, D-055)
    Generated with the pcb/gen schematic layer: Waveshare J7 header map,
    LTV-817 fail-off fan stage (Q1 held on from +10V_F), tach, 24 VAC
    occupancy, SEN65 with DNP pull-up pads, GPIO0 -> 2N7002 -> 470 R ->
    6 x SK6812SIDE-A. ERC 0 violations; carrier netlist assertions pass and
    were mutation-checked. SK6812SIDE-A footprint from LCSC, pads remapped.
    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
    [bom-raw.csv, carrier.kicad_sch]
2026-11-10 Bench plan for route B: rework checks and breadboarded fan stage
    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
2026-11-10 Switch to Waveshare ESP32-S3-Touch-LCD-3.5 (D-056)
    SPI panel frees ten header GPIOs and the IMU sits at 0x6A, so the
    D-054 cuts (FAN_PRESENT, DC_IN) and reworks go away. 3.3 V depends on
    the AXP2101 powering on, which is an eFuse option at VBUS insertion, so
    the carrier gets a PWRON one-shot. USB-C exposed via a stepped wall.
    Adds both schematic revisions under docs/vendor/waveshare-3.5.
    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
2026-11-10 Docs for the Waveshare 3.5 (D-056): pin plan, restored FR-18/IR-01, AXP2101 power
    Interfaces §2 gets the J8 map (Rev 2.0 numbering with V1 alongside; same
    physical positions) and GPIO38-42/21 assignments; FAN_PRESENT and the
    wired DC input return in requirements, interfaces, architecture and
    control logic. §3 documents that 3.3 V depends on the AXP2101 powering on
    and specifies the DNP PWRON one-shot. Adds the dimension drawing.
    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
2026-11-10 Carrier for the Waveshare 3.5: J8 header, presence and DC optos, DNP PWRON one-shot
    Regenerated pcb/carrier for the 2x16 header (Rev 2.0 numbering), GPIO38-42
    for the fan and inputs, GPIO21 for the indicator. Restores the presence
    opto and the wired DC input (D-025). Adds a DNP VBUS-triggered one-shot on
    the AXP2101 PWRON line. ERC 0; check.py extended and mutation-checked.
    Bench plan now checks AXP2101 power-on instead of the 2.8B rework.
    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
    [bom-raw.csv, carrier.kicad_sch]
2026-11-10 Mech direction: landscape, wiring out the left, SEN65 behind the panel (D-057 proposed, Q-46)
    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
2026-11-10 Accept D-057: SEN65 inside the sealed enclosure, no hatch (Q-46)
    NFR-04 now requires the module's inlet/outlet sealed to the wall instead
    of an open bay; NFR-03 relaxed so the module is reached by opening the
    enclosure (Andrew). AC-14/AC-15, interfaces §5 and architecture §5
    updated; D-019 superseded.
    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
2026-11-10 Compact stack-up: LEDs on the carrier's display side, SEN65 1/4" behind with foam (D-055, D-057)
    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
2026-11-11 Concept enclosure and first carrier placement (D-058)
    mech/: build123d concept driven by the Waveshare STEP (fetched, not
    committed): bezel + rear shell, stepped USB-C pocket, cable reliefs,
    LED diffuser, SEN65 standing on end with sealed ports through the right
    wall. 13 geometry tests pass (header engagement, clearances, SEN65 gap
    and apertures, USB plug vs display, walls, board-derived positions).
    Enclosure 97.4 x 66.0 x 53.7 mm.
    pcb/carrier/layout: locked placement from the netlist and the mech
    handoff; J1 asserted onto Waveshare J8, LED/J5/terminal orientations
    derived from footprint geometry, barrier keepouts, DRC 0 errors before
    routing.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
    [carrier-placed.kicad_pcb, carrier.kicad_sch, concept.step]
2026-11-11 Concept rev 2: no bezel, 1.6 mm walls, carrier tight to the Waveshare (D-059)
    Andrew's review of the D-058 concept:
    - No bezel: the cover glass is the front face. The outline is the glass
    (92.44 x 61.0), with walls on its border through a foam rim gasket.
    - 1.6 mm SLS walls with back-panel ribs instead of thicker walls.
    - Carrier as close as possible: J8 male header body on the carrier back
    (standard 6 mm posts, 3.1 mm engagement); carrier top 0.5 mm below the
    Waveshare camera. Depth 47.1 mm (was 53.7).
    - SEN65 connector corrected to the face opposite the ports (mech guide
    Fig. 1). It faces a bay beside the module, so the 0.4 mm back clearance
    works and the cable is short.
    Retenti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
    [carrier-placed.kicad_pcb, carrier.kicad_sch, concept.step]
2026-11-11 J8 header fitted normally with short posts; depth 48.3 mm (D-059, Q-47)
    Andrew: the body-on-back fitting means soldering from the display side,
    and those fillets would block full insertion. Not worth 1.2 mm. With the
    body seated on the socket face, the posts must be about 3 mm (a standard
    6 mm post reaches the Waveshare PCB through the 5.1 mm socket). Q-47 is
    the sourcing check; the fallback is a standard header on 6 mm spacers
    (+2.4 mm).
    D-059 also records why the carrier wasn't shrunk: there's no fab-cost
    gain under JLC's 100 x 100 tier. 17 mech tests pass; DRC has 0 errors
    before routing.
    Claude-Session: https://claude.ai/code/sess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
    [carrier-placed.kicad_pcb, carrier.kicad_sch, concept.step]
2026-11-11 Q-47: C2894977 is a standard 6 mm-post header; default to trimming the posts
    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
2026-11-11 Carrier flush on J8 with loose pins; camera excluded; opto clash found (D-059, Q-48)
    Andrew: the camera module in Waveshare's STEP isn't shipped. J1 stays
    unpopulated; he pushes loose pins into J8, seats the carrier flush and
    solders from the back. Carrier top moves to the socket face (z -11.5),
    and the depth is 45.8 mm.
    With 5.1 mm between the boards, the clearance test now checks actual
    Waveshare solids (mesh vertices) instead of assembly bounding boxes.
    It fails on U2/U5 (LTV-817S, 4.0 mm) against Waveshare back-side parts.
    That's Q-48, and it blocks routing. 17 of 18 mech tests pass; output is
    in mech/out/test-results.txt.
    There's no room for a USB-C pocket floor above the carrier, so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
    [carrier-placed.kicad_pcb, carrier.kicad_sch, concept.step]
2026-11-11 Q-48 (b): pack the optos into the Waveshare's clear column; terminals inboard (D-060)
    Andrew chose option (b) for the opto heights and asked for the terminals to sit inboard,
    facing left, with room on the left to dress the wires.
    - Optos: all five LTV-817S at a 5.6 mm pitch in the one column the Waveshare back leaves clear
    for a 4.0 mm part (frame E y -8.4 to +19.69). Margins 0.20 to 0.76 mm; field pads of adjacent
    groups 1.56 mm apart.
    - Terminals: pins at board x 11 (was 4.5), entries 7.6 mm from the inner wall; back-left strip
    clear except the screw heads. Field parts on the front, left of the pins. OCC|DC gap Z-shaped.
    - Mech: the clearance test uses per-solid boxes (catches flat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
    [carrier-placed.kicad_pcb, concept.step]
2026-11-12 Optos to the board-centre column, terminals mid-board; remove the old board; commit the Waveshare STEP (D-061)
    Andrew asked for the terminals further toward the middle (facing x = 0), test points on the
    bottom, the old design out of pcb/, and the Waveshare STEP in git.
    - Optos: rotating them in the D-060 column would put U1's field pads ~1 mm from J8 (needs 3.0).
    A scan of the Waveshare back finds a longer clear column at the board centre (frame E x -2..11,
    38.9 mm); optos go there in normal orientation. The barrier runs down it and turns left under J8,
    so the field side is the lower-left. Smallest opto margin 0.26 mm.
    - Terminals: pins at board x 33, 29.6 mm of wire room to the left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
    [bom-raw.csv, carrier-placed.kicad_pcb, concept.step, exhaust-placed.kicad_pcb, exhaust.dsn, exhaust.kicad_sch]
